Simo-realman/Two-Finger-Gripper/doc/image7.jpg

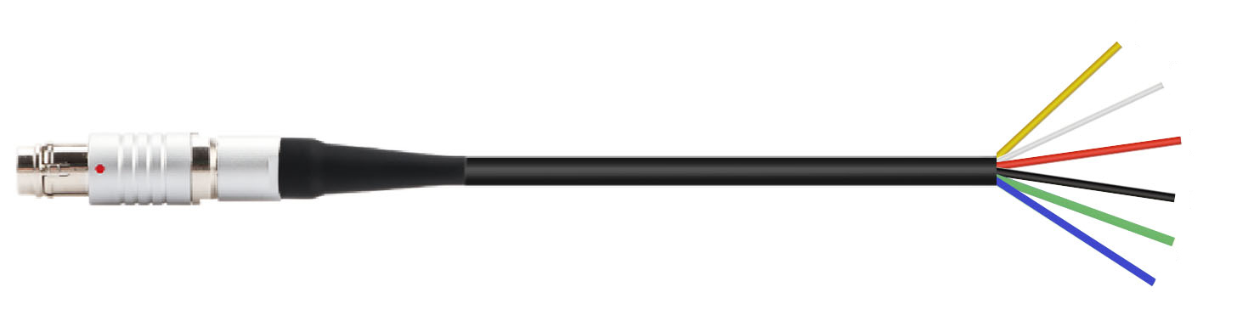
doc/image7.jpg
