Simo-realman/Two-Finger-Gripper/Software/gripper_app/Code/algo/release/structural_sketch.png

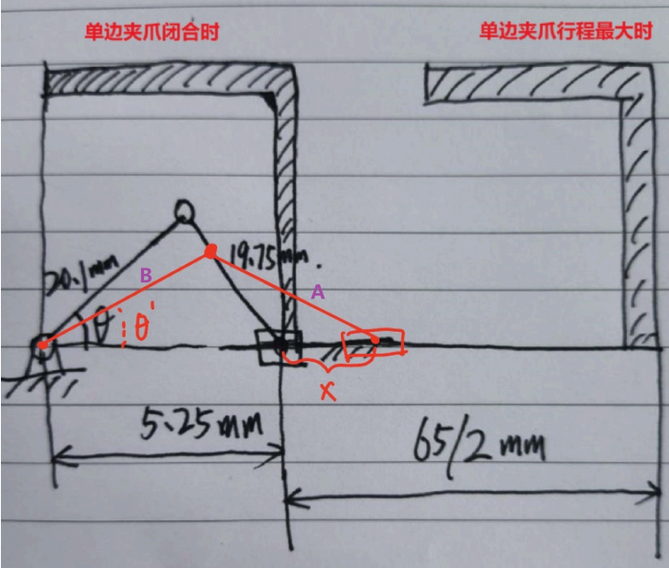
Software/gripper_app/Code/algo/release/structural_sketch.png
