Simo-realman/Two-Finger-Gripper/Software/gripper_tool/image/mainpage.jpg

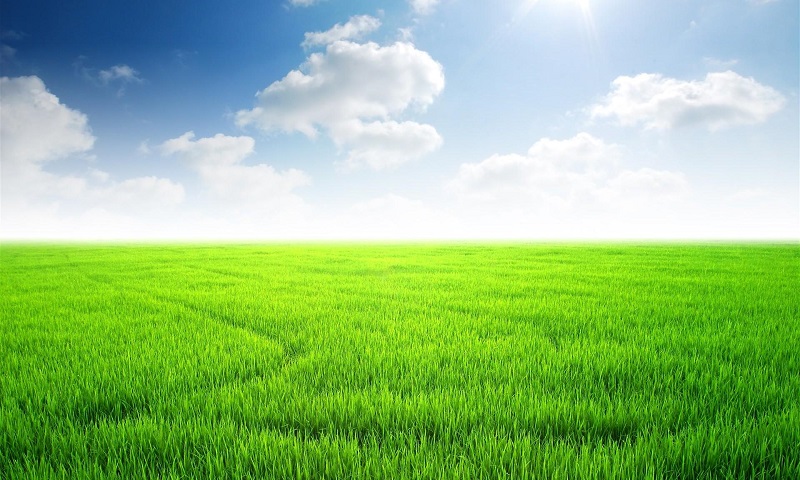
Software/gripper_tool/image/mainpage.jpg
