Simo-realman/Two-Finger-Gripper/Hardware/BOM/Claw Interface Board BOM.xls

夹爪转接板V2.0.0 BOM（20240814）（料号：020201.00**）
序号 | 料号（新） | 料号 | 元件类型 | 品牌 | 推荐型号 | 购买历史/替代型号 | 元件规格 | 封装 | 位置 | 数量
1 | 030103.0001 | RM.311030004 | 贴片电阻 | 国巨 | 0402WGF0000TCE | AC0402FR-070RL | 0R ±1% 0402 | 0402R | R1, R98 | 2
2 | 030103.0073 | RM.311030130 | 贴片电阻 | 厚声 | 0603WAF0000T5E |  | 0R ±1% 0603 | 0603 | F7,R58 | 2
3 | 030103.0042 | RM.311030092 | 贴片电阻 | 国巨 | RC0402FR-07120RL |  | 120Ω ±1% 0402 | 0402R | R29 | 1
4 | 030103.0041 | RM.311030091 | 贴片电阻 | 国巨 | RC0603FR-07120RL | RTT031200FTP | 120R 1% 0603 | 0603R | R27 | 1
5 | 030103.0032 | RM.311030073 | 贴片电阻 | 厚声 | 0402WGF1501TCE | RC0402FR-071K5L | 1.5K 5% 0402 | 0402R | R56, | 1
6 | 030103.0057 | RM.311030113 | 贴片电阻 | 国巨 | 0402WGF4701TCE | RC0402FR-074K7L | 4.7K ±1% 0402 | 0402R | R33,R42 | 2
7 | 030103.0076 | RM.311030133 | 贴片电阻 | 厚声 | 1206W4J0622T5 |  | 6.2k 5% 1206 | R1206 | R32, R41 | 2
8 | 030103.0031 | RM.311030071 | 贴片电阻 | 国巨 | RC0402FR-0710KL | /CR0402F10K0Q10Z/ AC0402FR-0710KL | 10kΩ ±1% 0402 | 0402R | R39, R52, R54,R16,R36,R37,R31, R51, R53 | 9
9 | 030103.0077 | RM.311030134 | 贴片电阻 | 国巨 | RC0402FR-0713K7L |  | 13.7K ±1% 0402 | 0402R | R12 | 1
10 | 030103.0072 | RM.311030100 | 贴片电阻 | 国巨 | RC0402FR-0720KL | AC0402FR-0720KL | 20kΩ ±1% 0402 | 0402R | R7 | 1
11 | 030103.0038 | RM.311030086 | 贴片电阻 | 厚声 | 0402WGF1003TCE | /RTT021003FTH/ RC-02W1003FT | 100kΩ ±1% 0402 | 0402R | R4, R6, R21 | 3
12 | 030103.0045 | RM.311030095 | 贴片电阻 | 厚声 | 0402WGF1503TCE | CRCW0402150KFKED | 150kΩ ±1% 0402 | 0402R | R9 | 1
13 | 030104.0027 | RM.311040054 | 贴片电容 | FH(风华) | 0402CG150F500NT | C0402C0G150G500NTB | 15pF ±1% 50V C0G 0402 | 0402C | C22 | 1
14 | 030104.0049 | RM.311040083 | 贴片电容 | 国巨 | CC0402JRNPO9BN331 | C1005NP0331JGT | 330pF ±5% 50V NPO 0402 | 0402C | C12 | 1
15 | 030104.0052 | RM.311040087 | 贴片电容 | FH(风华) | 0402B822K500CT/ |  | 8.2nF ±10% 50V X7R 0402 | 0402C | C18 | 1
16 | 030104.0008 | RM.311040088 | 贴片电容 | 国巨 | CC0402JRX7R9BB103 |  | 10nF ±5% 50V X7R 0402 | 0402C | C37, C39, C41 | 3
17 | 030104.0023 | RM.311040048 | 贴片电容 | 国巨 | CC0402KRX7R9BB104 |  | 100nF ±10% 50V X7R 0402 | 0402C | C3, C7, C8, C13, C23, C25, C26, C28, C30, C32, C35,C38, C40, C51,C5 | 15
18 | 030104.0026 | RM.311040053 | 贴片电容 | 国巨 | CC0805KKX7R0BB104 | C2012X7R2A104K125AA | 100nF ±10% 100V X7R 0805 | 0805C | C1 | 1
19 | 030104.0028 | RM.311040055 | 贴片电容 | 国巨 | CC0603KRX7R6BB105 |  | 1uF ±10% 10V X7R 0603 | 0603C | C19, C20,C29, | 3
20 | 030104.0036 | RM.311040064 | 贴片电容 | muRata(村田) | GRM21BR61A476ME15L |  | 47uF ±20% 10V X5R 0805 | 0805C | C9, C10 | 2
21 | 030104.0043 | RM.311040072 | 贴片电容 | PSA(信昌电陶) | FS32X106K500EGG | UMK325BJ106KM-P | 10uF(106) ±10% 50V X7R 1210 | C1210 | C11 | 1
22 | 030104.0019 | RM.311040037 | 贴片电容 | 三星 | CL31B106KBHNNNE |  | 10uF ±10% 50V X7R 1206 | 1206C | C2 ,C52, C53, C55, C56 | 5
23 | 030104.0038 | RM.311040066 | 贴片电容 | muRata(村田) | GRM21BR61H106KE43L |  | 10uF ±10% 50V X5R 0805 | 0805C | C14, | 1
24 | 030104.0017 | RM.311040033 | 贴片电容 | muRata(村田) | GRM188Z71A106KA73D |  | 10uF ±10% 10V X7R 0603 | 0603C | C27, C31 | 2
25 | 030104.0037 | RM.311040065 | 贴片电容 | 三星 | CL21A226MAYNNNE |  | 22uF ±20% 25V X5R 0805 | 0805C | C15, C16, C17, C48 | 4
26 | 030109.0002 | RM.311090005 | 磁珠BEAD | Sunlord(顺络) | GZ1005E601CTF |  | 磁珠600 Ohms@100MHz | 0402R | L3 | 1
27 | 030106.0024 | RM.311060043 | 二极管 | MDD | SS54F |  | SS54F 40V 5A 550mV@5A 肖特基二极管 | SMAF | D2 | 1
28 | 030106.0016 | RM.311060027 | 二极管 | 时科 | SS26FL |  | SS26FL SMAF | SS26FL | D6 | 1
29 | 030109.0008 | RM.311090028 | 贴片电感 | BOURNS | SRN8040TA-150M |  | SRN8040TA-150M 15uH 3.6A 50mΩ | VLP8040 | L1 | 1
30 | 030109.0003 | RM.311090018 | 贴片电感 | Sunlord(顺络) | SWPA4030S3R3MT |  | 贴片功率电感3.3uH ±20% 2.4A | L4030 | L2 | 1
31 | 030102.0032 | RM.311020061 | 电源芯片 | TI(德州仪器) | LMR14020SDDAR |  | LMR14020SDDAR DC-DC电源芯片//SO PowerPAD-8 降压型 输入电压：4V~40V 输出电压：800mV~28V 输出电流(最大值)：2A | HSOP-8-EP | U1 | 1
32 | 030102.0047 | RM.311020079 | 电源芯片 | TI(德州仪器) | LMR51420YDDC |  | LMR51420YDDC 降压型 输入4.5V~36V 输出600mV~34.2V 2A | TSOT23-6 | U2 | 1
33 | 030102.0026 | RM.311020050 | 电源芯片 | MICRONE(南京微盟) | ME6215C33M5G |  | ME6215C33M5G SOT23-5 | SOT-23-5 | U3 | 1
34 | 030102.0056 | RM.311020020 | CAN芯片 | 3PEAK | TPT1256L1-DF6R | MCP2544FDT-H/MF | CAN FD transceiver | DFN8 | U5 | 1
35 | 030102.0004 | RM.311020005 | 主芯片 | ST | STM32G431CBU6 库存带Y标志优先用 |  | STM32G431CBU6 | UFQFPN48 | U6 | 1
36 | 030102.0066 | RM.311020021 | RS485芯片 | SIT(芯力特) | SIT3088EEUA（030102.0066） | SIT3485EUA （030102.0012） | 收发器 驱动器/接收器：1/1 数据速率：12Mbps 小外型封装，3.3V供电，256节点，12Mbps，半双工RS485/ | VSSOP8/ MSOP-8 | U7 | 1
37 | 030102.0014 | RM.311020024 | 光耦 | RENESAS(瑞萨) | PS2801-1-F3 | IS2801 | 光耦 PS2801-1 SOP-4 | SSOP4 | U9, U12 | 2
38 | 030102.0037 | RM.311020069 | 达林顿管 | Mixic(中科芯亿达) | ULN2001D |  | ULN2001D SOP-8 | SOP-8 | U10 | 1
39 | 030108.0004 | RM.311080007 | 有源晶振 | SCTF(星通时频) | SX3M8.000M20F30TNN |  | 8M 3.3V SMD3225-4P | XTAL_3225 | Y1 | 1
40 | 030106.0017 | RM.311060032 | LED RGB | TUOZHAN(拓展光电) | S4-3528RGBTA-A |  | RGB3528共阳极 | LED_3528 | RGB1 | 1
41 |  | RM.311060022 | 二极管 | MDD/晶导微 | SMAJ40CA |  | SMAJ40CA | SMA_L4.4-W2.8-LS5.1-BI | D5 | 1
42 |  |  | 二极管 | CJ(江苏长电 /长晶) | ESDBW18VD3 |  | 静电和浪涌保护 | SOD-323A | D7 | 1
43 |  | RM.311060056 | 稳压管 | LRC(乐山无线电） | LBZT52C5V6T1G |  | 稳压值(标称值)：5.6V 稳压值(范围)：5.2V~6V 功率：500mW | SOD-123 | D9 | 1
44 |  |  | ESD保护器件 | Brightking (君耀电子) | LBT23C24L02 |  | LBT23C24L02 | SOT-23-3 | ESD1 | 1
5 | 030103.0032 | RM.311030073 | 贴片电阻 | 厚声 | 0402WGJ0680TCE |  | 68Ω 5% 0402 | 0402R | R55, R57 | 2
 |  |  | ESD保护器件 | TECH PUBLIC (台舟) | ESD5302F |  | ESD5302F | SOT-23-3 | ESD1 | 1
 |  |  | 更新事项：
 |  |  | 1>.将ESDLBT23C24L02替换为ESD5302F
 |  |  | 2>.
 |  |  | 3>.
 |  |  | 4>,
 |  |  | 5>,
