Simo-realman/Two-Finger-Gripper/Related Files/Two-Finger Parallel Gripper Test Cases.xlsx

Sheet: 整机结构测试
序号 | 模块 | 优先级 | 概要 | 描述 | 前提条件 | 步骤 | 预期结果 | 执行结果
NO.1 | 两指平行夹爪 | Medium | 整机尺寸 |  | 1、待测试夹爪 2、长度测量工具 | 1、使用量具对产品的长、宽、高进行测量 | 使用卡尺测量夹爪的三维尺寸（长、宽、高），确认是否在110x60x120mm的公差范围内
NO.2 | 两指平行夹爪 | Medium | 外观 |  | 1、待测试夹爪 | 1、观察夹爪外观 | 夹爪的外观简约、流畅、圆润，颜色为黑白相间，并喷漆质量均匀无瑕疵。
NO.3 | 两指平行夹爪 | Medium | 行程 |  | 1、待测试夹爪 2、长度测量工具 | 1、将夹爪打开至最大开口度 2、使用量具对产品的行程进行测量 | 夹爪行程：65mm±0.5mm
NO.4 | 两指平行夹爪 | Medium | 指高 |  | 1、待测试夹爪 2、长度测量工具 | 1、使用量具对产品的指高进行测量 | 夹爪指高：40mm±0.5mm
NO.5 | 两指平行夹爪 | Medium | 本体重量 |  | 1、待测试夹爪 2、质量测量工具 | 1、使用量具对产品的质量进行测量 | 夹爪质量：≤500g±10g
NO.6 | 两指平行夹爪 | Medium | 额定负载3.5kg（静态夹爪垂直向下夹取） |  | 1、待测试夹爪 2、连接到机械臂末端 3、机械臂上电初始化完成 | 1、进入web示教器：192.168.1.18 2、进入拓展-末端控制 3、点击工具端电源输出，选中24V 4、勾选夹爪进行夹爪使能 5、使用夹爪夹取3.5kg重物 6、观察夹爪夹取情况 | 夹爪能够静态夹取3.5kg重物不掉落
NO.7 | 两指平行夹爪 | Medium | 额定负载3.5kg（静态夹爪水平方向夹取） |  | 1、待测试夹爪 2、连接到机械臂末端 3、机械臂上电初始化完成 | 1、进入web示教器：192.168.1.18 2、进入拓展-末端控制 3、点击工具端电源输出，选中24V 4、勾选夹爪进行夹爪使能 5、使用夹爪夹取3.5kg重物 6、观察夹爪夹取情况 | 夹爪能够静态夹取3.5kg重物不掉落
NO.8 | 两指平行夹爪 | Medium | 额定负载3.5kg（静态夹爪垂直向上夹取） |  | 1、待测试夹爪 2、连接到机械臂末端 3、机械臂上电初始化完成 | 1、进入web示教器：192.168.1.18 2、进入拓展-末端控制 3、点击工具端电源输出，选中24V 4、勾选夹爪进行夹爪使能 5、使用夹爪夹取3.5kg重物 6、观察夹爪夹取情况 | 夹爪能够静态夹取3.5kg重物不掉落
NO.9 | 两指平行夹爪 | Medium | 额定负载3.5kg（静态夹爪夹取方向与地面形成45°夹角夹取） |  | 1、待测试夹爪 2、连接到机械臂末端 3、机械臂上电初始化完成 | 1、进入web示教器：192.168.1.18 2、进入拓展-末端控制 3、点击工具端电源输出，选中24V 4、勾选夹爪进行夹爪使能 5、使用夹爪夹取3.5kg重物 6、观察夹爪夹取情况 | 夹爪能够静态夹取3.5kg重物不掉落
NO.10 | 两指平行夹爪 | Medium | 额定负载3.5kg（静态夹爪夹取方向与地面形成135°夹角夹取） |  | 1、待测试夹爪 2、连接到机械臂末端 3、机械臂上电初始化完成 | 1、进入web示教器：192.168.1.18 2、进入拓展-末端控制 3、点击工具端电源输出，选中24V 4、勾选夹爪进行夹爪使能 5、使用夹爪夹取3.5kg重物 6、观察夹爪夹取情况 | 夹爪能够静态夹取3.5kg重物不掉落
NO.11 | 两指平行夹爪 | Medium | 额定负载3.5kg动态夹取 |  | 1、待测试夹爪 2、连接到机械臂末端 3、机械臂上电初始化完成 | 1、进入web示教器：192.168.1.18 2、进入拓展-末端控制 3、点击工具端电源输出，选中24V 4、勾选夹爪进行夹爪使能 5、使用夹爪夹取3.5kg重物 6、进入在线编程，编写使机械臂在各种姿态运行程序任务循环 7、观察机械臂运行时夹爪夹取情况 | 夹爪能够动态夹取3.5kg重物不掉落
NO.12 | 两指平行夹爪 | Medium | 最大负载5kg（静态夹爪垂直向下夹取） |  | 1、待测试夹爪 2、连接到机械臂末端 3、机械臂上电初始化完成 | 1、进入web示教器：192.168.1.18 2、进入拓展-末端控制 3、点击工具端电源输出，选中24V 4、勾选夹爪进行夹爪使能 5、使用夹爪夹取5kg重物 6、观察夹爪夹取情况 | 夹爪能够静态夹取5kg重物不掉落
NO.13 | 两指平行夹爪 | Medium | 最大负载5kg（静态夹爪水平方向夹取） |  | 1、待测试夹爪 2、连接到机械臂末端 3、机械臂上电初始化完成 | 1、进入web示教器：192.168.1.18 2、进入拓展-末端控制 3、点击工具端电源输出，选中24V 4、勾选夹爪进行夹爪使能 5、使用夹爪夹取5kg重物 6、观察夹爪夹取情况 | 夹爪能够静态夹取5kg重物不掉落
NO.14 | 两指平行夹爪 | Medium | 最大负载5kg（静态夹爪垂直向上夹取） |  | 1、待测试夹爪 2、连接到机械臂末端 3、机械臂上电初始化完成 | 1、进入web示教器：192.168.1.18 2、进入拓展-末端控制 3、点击工具端电源输出，选中24V 4、勾选夹爪进行夹爪使能 5、使用夹爪夹取5kg重物 6、观察夹爪夹取情况 | 夹爪能够静态夹取5kg重物不掉落
NO.15 | 两指平行夹爪 | Medium | 最大负载5kg（静态夹爪夹取方向与地面形成45°夹角夹取） |  | 1、待测试夹爪 2、连接到机械臂末端 3、机械臂上电初始化完成 | 1、进入web示教器：192.168.1.18 2、进入拓展-末端控制 3、点击工具端电源输出，选中24V 4、勾选夹爪进行夹爪使能 5、使用夹爪夹取5kg重物 6、观察夹爪夹取情况 | 夹爪能够静态夹取5kg重物不掉落
NO.16 | 两指平行夹爪 | Medium | 最大负载5kg（静态夹爪夹取方向与地面形成135°夹角夹取） |  | 1、待测试夹爪 2、连接到机械臂末端 3、机械臂上电初始化完成 | 1、进入web示教器：192.168.1.18 2、进入拓展-末端控制 3、点击工具端电源输出，选中24V 4、勾选夹爪进行夹爪使能 5、使用夹爪夹取5kg重物 6、观察夹爪夹取情况 | 夹爪能够静态夹取5kg重物不掉落
NO.17 | 两指平行夹爪 | Medium | 夹持力测试 |  | 1、待测试夹爪 2、上位机软件 3、测力计 4、夹爪和测力计上电处于工作状态 | 1、上位机设置夹爪的夹取速度为1000，夹取力为1000 2、将测力计放置在夹爪的夹指之间 3、点击持续夹取按钮 4、使用量具对产品的夹持力进行测量 | 夹持力最大可达60N
NO.18 | 两指平行夹爪 | Medium | 打开/闭合时间 |  | 1、待测试夹爪 2、串口测试工具 3、夹爪上电后处于工作状态 | 1、串口工具和夹爪通讯完成 2、在串口工具上设置夹爪开合循环、命令下发时间：300ms 3、开始循环，并观察夹爪开合状态 | 单行程开/合时间为0.3s
NO.19 | 两指平行夹爪 | Medium | 位置重复精度 |  | 1、待测试夹爪 2、上位机软件 3、千分表 4、测试工装 5、完成夹爪，千分表和测试工装的组装（参考图5） | 1、控制夹爪打开/闭合 2、计算夹爪的位置重复精度 | 夹爪位置重复精度为±0.1mm
NO.20 | 两指平行夹爪 | Medium | 夹爪指尖更换 |  | 1、带测试夹爪 2、匹配的螺丝 3、原装夹指和外夹指 | 1、将原配指尖拆卸，替换为外夹指 | 产品可通过替换夹指，满足更多的目标抓取的需要
NO.21 | 两指平行夹爪 | Medium | 外夹指行程 |  | 1、待测试外夹指 2、长度测量工具 | 1、使用量具对产品的外夹指行程进行测量 | 100mm
NO.22 | 两指平行夹爪 | Medium | 安装角度 |  | 1、待测试夹爪、末端法兰转接件件、视觉相机、适配固定螺、RM65b机械臂 | 1、按先后顺序将视觉相机，夹爪安装至RM65b机械臂末端 2、观察安装后夹爪角度是否与相机平行 3、通过web示教器开合夹爪，观察夹爪开合是否影响相机拍摄 | 夹爪的安装角度与相机平行
NO.23 | 两指平行夹爪 | Medium | 末端法兰，快插接口安装 |  | 1、待测试夹爪，末端法兰转接件，RM65B机械臂，适配螺丝及工具 2、双头航插线 | 1、将夹爪通过末端法兰安装至RM65B机械臂末端 2、使用双头航插线连接机械臂末端和夹爪 | 可通过末端法兰和快插接口快速安装夹爪满足工作环境需要
NO.24 | 两指平行夹爪 | Medium | 航插位置 |  | 1、待测试夹爪 | 1、观测航插接口位置 | 航插接口位于夹爪台阶下面
NO.25 | 两指平行夹爪 | Medium | 掉电缓冲（正在打开） |  | 1、待测试夹爪 2、移动电源 3、夹爪上位机供电 4、使夹爪处于工作状态 | 1、上位机下发打开指令 2、夹爪打开到开口度500时，断电 3、观测夹爪掉电后状态 | 掉电后手爪受载荷重力影响，缓慢张开
NO.26 | 两指平行夹爪 | Medium | 掉电缓冲（正在闭合 |  | 1、待测试夹爪 2、移动电源 3、夹爪上位机供电 4、使夹爪处于工作状态 | 1、上位机下发闭合指令 2、夹爪闭合到开口度500时，断电 3、观测夹爪掉电后状态 | 掉电后手爪受载荷重力影响，缓慢张开
NO.27 | 两指平行夹爪 | Medium | 材料 |  | 1、待测试夹爪 | 1、检测夹爪材质 | 铝合金外壳为主、ABS为辅
NO.28 | 两指平行夹爪 | Medium | 外观 |  | 1、待测试夹爪 | 1、观察夹爪外观 | 外观简约、流畅、圆润，与RM机械臂风格相近，颜色为黑白相间
NO.29 | 两指平行夹爪 | Medium | 表面工艺 |  | 1、待测试夹爪 | 1、观察夹爪表面工艺 | 喷漆：喷砂氧化
NO.30 | 两指平行夹爪 | Medium | 额定电压 |  | 1、待测试夹爪 2、移动电源 3、夹爪上位机 | 1、将移动电源调整至24V电压，2A电流对夹爪进行供电 2、上位机下发打开闭合指令 3、观察夹爪工作状态 | 夹爪可在24V供电下使用
NO.31 | 两指平行夹爪 | Medium | 额定电流 |  | 1、待测试夹爪 2、移动电源 3、夹爪上位机 | 1、将移动电源调整至24V电压，0.8A电流对夹爪进行长时间供电 2、上位机下发打开闭合指令 3、观察夹爪工作状态 | 可用24V电压，0.8A电流对夹爪进行供电
NO.32 | 两指平行夹爪 | Medium | 最大电流 |  | 1、待测试夹爪 2、移动电源 3、夹爪上位机 | 1、将移动电源调整至24V电压，2.4A电流对夹爪进行长时间供电 2、上位机下发打开闭合指令 3、观察夹爪工作状态 | 可用24V电压，2.4A电流对夹爪进行供电
NO.33 | 两指平行夹爪 | Medium | 供电 |  | 1、待测试03关节 2、移动电源 | 1、使用20V电压，0.8A电流对03关节进行供电 | 03关节可正常运转
NO.34 | 两指平行夹爪 | Medium | 供电 |  | 1、待测试03关节 2、移动电源 | 1、使用30V电压，2.4A电流对03关节进行供电 | 03关节可正常运转
NO.35 | 两指平行夹爪 | Medium | 供电 |  | 1、待测试03关节 2、移动电源 | 1、使用10V电压，0.5A电流对03关节进行供电 | 供电功率无法支持03关节正常运转
NO.36 | 两指平行夹爪 | Medium | 供电 |  | 1、待测试03关节 2、移动电源 | 1、使用40V电压，4A电流对03关节进行供电 | 供电功率超出03关节运转负荷
NO.37 | 两指平行夹爪 | Medium | 最小夹持力 |  | 1、待测试03关节 3、移动电源 | 1、上位机设置夹爪的夹取速度为1，夹取力为50 2、将测力计放置在夹爪的夹指之间 3、点击持续夹取按钮 4、使用量具对产品的夹持力进行测量 | 不锈钢材质 单次夹取：5.8kg 持续夹取：6.4kg

Sheet: 重复定位精度测试1st
 | 航插接口左侧夹指 |  |  |  |  |  | 航插接口侧夹指
重复定位精度测试数据 | 开口度 | 实际距离（mm） | 开口度 | 实际距离（mm） | 开口度 | 实际距离（mm） | 开口度 | 实际距离（mm） | 开口度 | 实际距离（mm） | 开口度 | 实际距离（mm）
 | 50 |  | 70 |  | 100 |  | 50 |  | 70 |  | 100
 | 最大偏值 |  |  |  |  |  | 最大偏值
 | 基准值 |  |  |  |  |  | 基准值
 | 次数 |  |  |  |  |  | 次数
 | 左指 |  |  |  |  |  | 右指

Sheet: 嵌入式软件功能测试
序号 | 模块 | 优先级 | 概要 | 前提条件 | 步骤 | 预期结果 | 执行结果
NO.1 | 数据传输、采集和运动控制 | Medium | 保存参数 | 1、待测试夹爪 2、移动电源（24V供电） 3、485转usb通讯线 4、夹爪航插通讯线 5、完成1-4接线工作（参考图1） 6、设备上电 7、连接串口工具 | 1、通过串口工具下发保存参数指令：EB 90 01 01 01 03 | 1、接受应答帧：EE 16 01 02 01 01 05
NO.2 |  | Medium | 系统恢复默认参数 | 1、待测试夹爪 2、移动电源（24V供电） 3、485转usb通讯线 4、夹爪航插通讯线 5、完成1-4接线工作（参考图1） 6、设备上电 7、连接串口工具 | 1、随机修改系统参数（参考下方用例） 2、通过串口工具下发恢复默认参数指令：EB 90 01 01 02 04 3、断电重启设备 4、设备上电后，上位机查询系统参数 | 2、接受应答帧：EE 16 01 02 02 01 06 4、系统参数恢复默认
NO.3 |  | Medium | 设置波特率为9600 | 1、待测试夹爪 2、移动电源（24V供电） 3、485转usb通讯线 4、夹爪航插通讯线 5、完成1-4接线工作（参考图1） 6、设备上电 7、连接串口工具 | 1、通过串口工具下发设置波特率为9600指令：EB 90 01 02 03 00 06 2、通过串口工具下发保存参数指令：EB 90 01 01 01 03 3、断电重启设备 4、设备上电后，上位机查询波特率 | 1、接受应答帧：EE 16 01 02 03 01 07 2、接受应答帧：EE 16 01 02 01 01 05 3、波特率已修改为9600
NO.4 |  | Medium | 设置波特率为19200 | 1、待测试夹爪 2、移动电源（24V供电） 3、485转usb通讯线 4、夹爪航插通讯线 5、完成1-4接线工作（参考图1） 6、设备上电 7、连接串口工具 | 1、通过串口工具下发设置波特率为19200指令：EB 90 01 02 03 01 07 2、通过串口工具下发保存参数指令：EB 90 01 01 01 03 3、断电重启设备 4、设备上电后，上位机查询波特率 | 1、接受应答帧：EE 16 01 02 03 01 07 2、接受应答帧：EE 16 01 02 01 01 05 3、波特率已修改为19200
NO.5 |  | Medium | 设置波特率为38400 | 1、待测试夹爪 2、移动电源（24V供电） 3、485转usb通讯线 4、夹爪航插通讯线 5、完成1-4接线工作（参考图1） 6、设备上电 7、连接串口工具 | 1、通过串口工具下发设置波特率为38400指令：EB 90 01 02 03 02 08 2、通过串口工具下发保存参数指令：EB 90 01 01 01 03 3、断电重启设备 4、设备上电后，上位机查询波特率 | 1、接受应答帧：EE 16 01 02 03 01 07 2、接受应答帧：EE 16 01 02 01 01 05 3、波特率已修改为38400
NO.6 |  | Medium | 设置波特率为57600 | 1、待测试夹爪 2、移动电源（24V供电） 3、485转usb通讯线 4、夹爪航插通讯线 5、完成1-4接线工作（参考图1） 6、设备上电 7、连接串口工具 | 1、通过串口工具下发设置波特率为57600指令：EB 90 01 02 03 03 09 2、通过串口工具下发保存参数指令：EB 90 01 01 01 03 3、断电重启设备 4、设备上电后，上位机查询波特率 | 1、接受应答帧：EE 16 01 02 03 01 07 2、接受应答帧：EE 16 01 02 01 01 05 3、波特率已修改为57600
NO.7 |  | Medium | 设置波特率为115200 | 1、待测试夹爪 2、移动电源（24V供电） 3、485转usb通讯线 4、夹爪航插通讯线 5、完成1-4接线工作（参考图1） 6、设备上电 7、连接串口工具 | 1、通过串口工具下发设置波特率为57600指令：EB 90 01 02 03 04 0A 2、通过串口工具下发保存参数指令：EB 90 01 01 01 03 3、断电重启设备 4、设备上电后，上位机查询波特率 | 1、接受应答帧：EE 16 01 02 03 01 07 2、接受应答帧：EE 16 01 02 01 01 05 3、波特率已修改为115200
NO.8 |  | Medium | 设置波特率为460800 | 1、待测试夹爪 2、移动电源（24V供电） 3、485转usb通讯线 4、夹爪航插通讯线 5、完成1-4接线工作（参考图1） 6、设备上电 7、连接串口工具 | 1、通过串口工具下发设置波特率为57600指令：EB 90 01 02 03 05 0B 2、通过串口工具下发保存参数指令：EB 90 01 01 01 03 3、断电重启设备 4、设备上电后，上位机查询波特率 | 1、接受应答帧：EE 16 01 02 03 01 07 2、接受应答帧：EE 16 01 02 01 01 05 3、波特率已修改为460800
NO.9 |  | Medium | 设置夹爪id为1 | 1、待测试夹爪 2、移动电源（24V供电） 3、485转usb通讯线 4、夹爪航插通讯线 5、完成1-4接线工作（参考图1） 6、设备上电 7、连接串口工具 | 1、通过串口工具下发设置夹爪ID为1指令：EB 90 01 02 04 01 08 2、通过串口工具下发保存参数指令：EB 90 01 01 01 03 3、断电重启设备 4、设备上电后，上位机查询夹爪ID | 1、接受应答帧：EE 16 01 02 04 01 08 2、接受应答帧：EE 16 01 02 01 01 05 3、夹爪ID已设置为1
NO.10 |  | Medium | 设置夹爪id为7 | 1、待测试夹爪 2、移动电源（24V供电） 3、485转usb通讯线 4、夹爪航插通讯线 5、完成1-4接线工作（参考图1） 6、设备上电 7、连接串口工具 | 1、通过串口工具下发设置夹爪ID为1指令：EB 90 01 02 04 07 0E 2、通过串口工具下发保存参数指令：EB 90 01 01 01 03 3、断电重启设备 4、设备上电后，上位机查询夹爪ID | 1、接受应答帧：EE 16 01 02 04 01 08 2、接受应答帧：EE 16 01 02 01 01 05 3、夹爪ID已设置为7
NO.11 |  | Medium | 设置夹爪id为21 | 1、待测试夹爪 2、移动电源（24V供电） 3、485转usb通讯线 4、夹爪航插通讯线 5、完成1-4接线工作（参考图1） 6、设备上电 7、连接串口工具 | 1、通过串口工具下发设置夹爪ID为1指令：EB 90 01 02 04 15 1C 2、通过串口工具下发保存参数指令：EB 90 01 01 01 03 3、断电重启设备 4、设备上电后，上位机查询夹爪ID | 1、接受应答帧：EE 16 01 02 04 01 08 2、接受应答帧：EE 16 01 02 01 01 05 3、夹爪ID已设置为21
NO.12 |  | Medium | 设置夹爪id为35 | 1、待测试夹爪 2、移动电源（24V供电） 3、485转usb通讯线 4、夹爪航插通讯线 5、完成1-4接线工作（参考图1） 6、设备上电 7、连接串口工具 | 1、通过串口工具下发设置夹爪ID为1指令：EB 90 01 02 04 23 2A 2、通过串口工具下发保存参数指令：EB 90 01 01 01 03 3、断电重启设备 4、设备上电后，上位机查询夹爪ID | 1、接受应答帧：EE 16 01 02 04 01 08 2、接受应答帧：EE 16 01 02 01 01 05 3、夹爪ID已设置为35
NO.13 |  | Medium | 查询夹爪ID | 1、待测试夹爪 2、移动电源（24V供电） 3、485转usb通讯线 4、夹爪航插通讯线 5、完成1-4接线工作（参考图1） 6、设备上电 7、连接串口工具 | 1、通过串口工具下发查询夹爪ID指令：EB 90 FF 01 05 05 | 1、设备ID为1时应答帧：EE 16 01 02 05 01 09
NO.14 |  | Medium | 以设置的速度300和力控200夹取 | 1、待测试夹爪 2、移动电源（24V供电） 3、485转usb通讯线 4、夹爪航插通讯线 5、完成1-4接线工作（参考图1） 6、设备上电 7、连接串口工具 | 1、通过串口工具下发以力矩为200，速度为300单次夹取指令：EB 90 01 05 18 2C 01 C8 00 13 | 1、接受应答帧：EE 16 01 02 18 01 1C
NO.15 |  | Medium | 以设置的速度1和力控50夹取 | 1、待测试夹爪 2、移动电源（24V供电） 3、485转usb通讯线 4、夹爪航插通讯线 5、完成1-4接线工作（参考图1） 6、设备上电 7、连接串口工具 | 1、通过串口工具下发以力矩为50，速度为1单次夹取指令：EB 90 01 05 18 01 00 32 00 51 | 1、接受应答帧：EE 16 01 02 18 01 1C
NO.16 |  | Medium | 以设置的速度500和力控500夹取 | 1、待测试夹爪 2、移动电源（24V供电） 3、485转usb通讯线 4、夹爪航插通讯线 5、完成1-4接线工作（参考图1） 6、设备上电 7、连接串口工具 | 1、通过串口工具下发以力矩为500，速度为500单次夹取指令：EB 90 01 05 18 F4 01 F4 01 08 | 1、接受应答帧：EE 16 01 02 18 01 1C
NO.17 |  | Medium | 以设置的速度1000和力控1000夹取 | 1、待测试夹爪 2、移动电源（24V供电） 3、485转usb通讯线 4、夹爪航插通讯线 5、完成1-4接线工作（参考图1） 6、设备上电 7、连接串口工具 | 1、通过串口工具下发以力矩为1000，速度为1000单次夹取指令：EB 90 01 05 18 E8 03 E8 03 F4 | 1、接受应答帧：EE 16 01 02 18 01 1C
NO.18 |  | Medium | 以设置的速度1松开 | 1、待测试夹爪 2、移动电源（24V供电） 3、485转usb通讯线 4、夹爪航插通讯线 5、完成1-4接线工作（参考图1） 6、设备上电 7、连接串口工具 | 1、通过串口工具下发以速度为1松开夹取指令：EB 90 01 03 11 01 00 16 2、观察夹爪松开速度 | 1、接受应答帧：EE 16 01 02 11 01 15 2、夹爪按照1速度松开夹爪
NO.19 |  | Medium | 以设置的速度500松开 | 1、待测试夹爪 2、移动电源（24V供电） 3、485转usb通讯线 4、夹爪航插通讯线 5、完成1-4接线工作（参考图1） 6、设备上电 7、连接串口工具 | 1、通过串口工具下发以速度为500松开夹取指令：EB 90 01 03 11 F4 01 0A 2、观察夹爪松开速度 | 1、接受应答帧：EE 16 01 02 11 01 15 2、夹爪按照500速度松开夹爪
NO.20 |  | Medium | 以设置的速度1000松开 | 1、待测试夹爪 2、移动电源（24V供电） 3、485转usb通讯线 4、夹爪航插通讯线 5、完成1-4接线工作（参考图1） 6、设备上电 7、连接串口工具 | 1、通过串口工具下发以速度为1松开夹取指令：EB 90 01 03 11 E8 03 00 2、观察夹爪松开速度 | 1、接受应答帧：EE 16 01 02 11 01 15 2、夹爪按照1000速度松开夹爪
NO.21 |  | Medium | 设置夹爪开口度限位为0-1000 | 1、待测试夹爪 2、移动电源（24V供电） 3、485转usb通讯线 4、夹爪航插通讯线 5、完成1-4接线工作（参考图1） 6、设备上电 7、连接串口工具 | 1、通过串口工具下发设置夹爪开口度为0-1000指令：EB 90 01 05 12 E8 03 00 00 03 2、下发开合夹爪指令查看夹爪开口度（指令参考上方用例） 3、下发保存指令（参考上方用例） 4、断电重启生效 5、检查是否设置成功 | 1、接受应答帧：EE 16 01 02 12 01 16 2、开口限位0-1000 5、设置成功
NO.22 |  | Medium | 设置夹爪开口度限位200-800 | 1、待测试夹爪 2、移动电源（24V供电） 3、485转usb通讯线 4、夹爪航插通讯线 5、完成1-4接线工作（参考图1） 6、设备上电 7、连接串口工具 | 1、通过串口工具下发设置夹爪开口度为200-800指令：EB 90 01 05 12 20 03 C8 00 03 2、下发开合夹爪指令查看夹爪开口度（指令参考上方用例） 3、下发保存指令（参考上方用例） 4、断电重启生效 5、检查是否设置成功 | 1、接受应答帧：EE 16 01 02 12 01 16 2、开口限位200-800 5、设置成功
NO.23 |  | Medium | 设置夹爪开口度限位400-600 | 1、待测试夹爪 2、移动电源（24V供电） 3、485转usb通讯线 4、夹爪航插通讯线 5、完成1-4接线工作（参考图1） 6、设备上电 7、连接串口工具 | 1、通过串口工具下发设置夹爪开口度为400-600指令：EB 90 01 05 12 58 02 90 01 03 2、下发开合夹爪指令查看夹爪开口度（指令参考上方用例） 3、下发保存指令（参考上方用例） 4、断电重启生效 5、检查是否设置成功 | 1、接受应答帧：EE 16 01 02 12 01 16 2、开口限位400-600 5、设置成功
NO.24 |  | Medium | 查询夹爪开口度限位（400-600） | 1、待测试夹爪 2、移动电源（24V供电） 3、485转usb通讯线 4、夹爪航插通讯线 5、完成1-4接线工作（参考图1） 6、设备上电 7、连接串口工具 | 1、通过串口工具下发查询夹爪开口度指令：EB 90 01 01 13 15 2、检查开口度是否正确 | 1、接受应答帧：EE 16 01 05 13 58 02 90 01 04 2、查询的值对应夹爪实际开口度
NO.25 |  | Medium | 急停 | 1、待测试夹爪 2、移动电源（24V供电） 3、485转usb通讯线 4、夹爪航插通讯线 5、完成1-4接线工作（参考图1） 6、设备上电 7、连接串口工具 | 1、下发夹爪开合指令（参考上方用例） 2、通过串口工具下发查询夹爪开口度指令：EB 90 01 01 16 18 3、观察夹爪运动状态 | 2、接受应答帧：EE 16 01 02 16 01 1A 3、夹爪停止开合
NO.26 |  | Medium | 清楚错误 | 1、待测试夹爪 2、移动电源（24V供电） 3、485转usb通讯线 4、夹爪航插通讯线 5、完成1-4接线工作（参考图1） 6、设备上电 7、连接串口工具 | 1、通过串口工具下发清除错误指令：EB 90 01 01 17 19 | 1、接受应答帧：EE 16 01 02 17 01 1B
NO.27 |  | Medium | 以设置的速度300和力控200持续夹取 | 1、待测试夹爪 2、移动电源（24V供电） 3、485转usb通讯线 4、夹爪航插通讯线 5、完成1-4接线工作（参考图1） 6、设备上电 7、连接串口工具 | 1、通过串口工具下发以力矩为200，速度为300持续夹取指令：EB 90 01 05 18 2C 01 C8 00 13 | 1、接受应答帧：EE 16 01 02 18 01 1C
NO.28 |  | Medium | 以设置的速度1和力控50持续夹取 | 1、待测试夹爪 2、移动电源（24V供电） 3、485转usb通讯线 4、夹爪航插通讯线 5、完成1-4接线工作（参考图1） 6、设备上电 7、连接串口工具 | 1、通过串口工具下发以力矩为50，速度为1持续夹取指令：EB 90 01 05 18 01 00 32 00 51 | 1、接受应答帧：EE 16 01 02 18 01 1C
NO.29 |  | Medium | 以设置的速度500和力控500持续夹取 | 1、待测试夹爪 2、移动电源（24V供电） 3、485转usb通讯线 4、夹爪航插通讯线 5、完成1-4接线工作（参考图1） 6、设备上电 7、连接串口工具 | 1、通过串口工具下发以力矩为500，速度为500持续夹取指令：EB 90 01 05 18 F4 01 F4 01 08 | 1、接受应答帧：EE 16 01 02 18 01 1C
NO.30 |  | Medium | 以设置的速度1000和力控1000持续夹取 | 1、待测试夹爪 2、移动电源（24V供电） 3、485转usb通讯线 4、夹爪航插通讯线 5、完成1-4接线工作（参考图1） 6、设备上电 7、连接串口工具 | 1、通过串口工具下发以力矩为1000，速度为1000持续夹取指令：EB 90 01 05 18 E8 03 E8 03 F4 | 1、接受应答帧：EE 16 01 02 18 01 1C
NO.31 |  | Medium | 设置控制力为50 | 1、待测试夹爪 2、移动电源（24V供电） 3、485转usb通讯线 4、夹爪航插通讯线 5、完成1-4接线工作（参考图1） 6、设备上电 7、连接串口工具 | 1、通过串口工具下发设置控制力为50指令：EB 90 01 03 19 32 00 4F 2、下发保存指令（参考上方用例） 3、断电重启生效 4、检查控制力是否设置成功 | 1、接受应答帧：EE 16 01 02 19 01 1D 4、设置成功
NO.32 |  | Medium | 设置控制力为500 | 1、待测试夹爪 2、移动电源（24V供电） 3、485转usb通讯线 4、夹爪航插通讯线 5、完成1-4接线工作（参考图1） 6、设备上电 7、连接串口工具 | 1、通过串口工具下发设置控制力为50指令：EB 90 01 03 19 F4 01 12 2、下发保存指令（参考上方用例） 3、断电重启生效 4、检查控制力是否设置成功 | 1、接受应答帧：EE 16 01 02 19 01 1D 4、设置成功
NO.33 |  | Medium | 设置控制力为1000 | 1、待测试夹爪 2、移动电源（24V供电） 3、485转usb通讯线 4、夹爪航插通讯线 5、完成1-4接线工作（参考图1） 6、设备上电 7、连接串口工具 | 1、通过串口工具下发设置控制力为50指令：EB 90 01 03 19 E8 03 08 2、下发保存指令（参考上方用例） 3、断电重启生效 4、检查控制力是否设置成功 | 1、接受应答帧：EE 16 01 02 19 01 1D 4、设置成功
NO.34 |  | Medium | 设置IO1模式（输入） | 1、待测试夹爪 2、移动电源（24V供电） 3、485转usb通讯线 4、夹爪航插通讯线 5、完成1-4接线工作（参考图1） 6、设备上电 7、连接串口工具 | 1、通过串口工具下发设置IO1输入模式指令：EB 90 01 03 1B 00 00 1F 2、下发查询指令验证是否设置成功（指令参考读取IO输出电平用例） | 1、接受应答帧：EE 16 01 02 1B 01 1F 2、设置成功
NO.35 |  | Medium | 设置IO1模式（输出） | 1、待测试夹爪 2、移动电源（24V供电） 3、485转usb通讯线 4、夹爪航插通讯线 5、完成1-4接线工作（参考图1） 6、设备上电 7、连接串口工具 | 1、通过串口工具下发设置IO1输出模式指令：EB 90 01 03 1B 00 01 20 2、下发查询指令验证是否设置成功（指令参考读取IO输出电平用例） | 1、接受应答帧：EE 16 01 02 1B 01 1F 2、设置成功
NO.36 |  | Medium | 设置IO2模式（输入） | 1、待测试夹爪 2、移动电源（24V供电） 3、485转usb通讯线 4、夹爪航插通讯线 5、完成1-4接线工作（参考图1） 6、设备上电 7、连接串口工具 | 1、通过串口工具下发设置IO2输入模式指令：EB 90 01 03 1B 01 00 20 2、下发查询指令验证是否设置成功（指令参考读取IO输出电平用例） | 1、接受应答帧：EE 16 01 02 1B 01 1F 2、设置成功
NO.37 |  | Medium | 设置IO2模式（输出） | 1、待测试夹爪 2、移动电源（24V供电） 3、485转usb通讯线 4、夹爪航插通讯线 5、完成1-4接线工作（参考图1） 6、设备上电 7、连接串口工具 | 1、通过串口工具下发设置IO2输出模式指令：EB 90 01 03 1B 01 01 21 2、下发查询指令验证是否设置成功（指令参考读取IO输出电平用例） | 1、接受应答帧：EE 16 01 02 1B 01 1F 2、设置成功
NO.38 |  | Medium | 设置IO1输出电平（低电平） | 1、待测试夹爪 2、移动电源（24V供电） 3、485转usb通讯线 4、夹爪航插通讯线 5、完成1-4接线工作（参考图1） 6、设备上电 7、连接串口工具 | 1、通过串口工具下发设置IO1输出低电平指令：EB 90 01 03 1C 00 00 20 2、下发查询指令验证是否设置成功（指令参考读取IO输出电平用例） | 1、接受应答帧：EE 16 01 02 1C 01 20 2、设置成功
NO.39 |  | Medium | 设置IO1输出电平（高电平） | 1、待测试夹爪 2、移动电源（24V供电） 3、485转usb通讯线 4、夹爪航插通讯线 5、完成1-4接线工作（参考图1） 6、设备上电 7、连接串口工具 | 1、通过串口工具下发设置IO1输出高电平指令：EB 90 01 03 1C 00 01 21 2、下发查询指令验证是否设置成功（指令参考读取IO输出电平用例） | 1、接受应答帧：EE 16 01 02 1C 01 20 2、设置成功
NO.40 |  | Medium | 设置IO2输出电平（低电平） | 1、待测试夹爪 2、移动电源（24V供电） 3、485转usb通讯线 4、夹爪航插通讯线 5、完成1-4接线工作（参考图1） 6、设备上电 7、连接串口工具 | 1、通过串口工具下发设置IO2输出低电平指令：EB 90 01 03 1C 01 00 21 2、下发查询指令验证是否设置成功（指令参考读取IO输出电平用例） | 1、接受应答帧：EE 16 01 02 1C 01 20 2、设置成功
NO.41 |  | Medium | 设置IO2输出电平（高电平） | 1、待测试夹爪 2、移动电源（24V供电） 3、485转usb通讯线 4、夹爪航插通讯线 5、完成1-4接线工作（参考图1） 6、设备上电 7、连接串口工具 | 1、通过串口工具下发设置IO2输出高电平指令：EB 90 01 03 1C 01 01 22 2、下发查询指令验证是否设置成功（指令参考读取IO输出电平用例） | 1、接受应答帧：EE 16 01 02 1C 01 20 2、设置成功
NO.42 |  | Medium | 读取IO输出电平（IO1输出高电平，IO2输出低电平） | 1、待测试夹爪 2、移动电源（24V供电） 3、485转usb通讯线 4、夹爪航插通讯线 5、完成1-4接线工作（参考图1） 6、设备上电 7、连接串口工具 | 1、通过串口工具下发读取IO输出电平指令：EB 90 01 01 1D 1F | 1、接受应答帧：EE 16 01 05 1D 01 01 01 00 26
NO.43 |  | Medium | 读取夹爪状态（可参考睿尔曼两指平行夹爪用户手册） | 1、待测试夹爪 2、移动电源（24V供电） 3、485转usb通讯线 4、夹爪航插通讯线 5、完成1-4接线工作（参考图1） 6、设备上电 7、连接串口工具 | 1、通过串口工具下发读取夹爪状态指令：EB 90 01 01 41 43 2、检查指令是否与夹爪实际状态对应 | 1、接受应答帧：EE 16 01 08 41 03 00 2C 01 00 0A 00 84 2、通过
NO.44 |  | Medium | 读取夹爪系统参数（可参考睿尔曼两指平行夹爪用户手册） | 1、待测试夹爪 2、移动电源（24V供电） 3、485转usb通讯线 4、夹爪航插通讯线 5、完成1-4接线工作（参考图1） 6、设备上电 7、连接串口工具 | 1、通过串口工具下发读取夹爪状态指令：EB 90 01 01 42 44 2、检查指令是否与夹爪实际状态对应 | 1、接受应答帧：EE 16 01 0F 42 01 04 00 00 E8 03 2C 01 E8 03 67 00 41 6C 6E 2、通过
NO.45 |  | Medium | 查询夹爪电机状态 | 1、待测试夹爪 2、移动电源（24V供电） 3、485转usb通讯线 4、夹爪航插通讯线 5、完成1-4接线工作（参考图1） 6、设备上电 7、连接串口工具 | 1、通过串口工具下发读取夹爪状态指令：EB 90 01 01 43 45 2、检查指令是否与夹爪实际状态对应 | 1、接受应答帧：EE 16 01 1F 43 01 02 00 00 52 30 25 44 00 00 B8 41 4B 59 06 3C 00 00 00 00 00 00 86 42 00 00 25 44 00 00 61 2、通过
NO.46 |  | Medium | 设置开口度（0） | 1、待测试夹爪 2、移动电源（24V供电） 3、485转usb通讯线 4、夹爪航插通讯线 5、完成1-4接线工作（参考图1） 6、设备上电 7、连接串口工具 | 1、通过串口工具下发设置夹爪开口度为0指令：EB 90 01 03 54 00 00 58 2、检查指令是否与夹爪实际状态对应 | 1、接受应答帧：EE 16 01 02 54 01 58 2、通过
NO.47 |  | Medium | 设置开口度（500） | 1、待测试夹爪 2、移动电源（24V供电） 3、485转usb通讯线 4、夹爪航插通讯线 5、完成1-4接线工作（参考图1） 6、设备上电 7、连接串口工具 | 1、通过串口工具下发设置夹爪开口度为0指令：EB 90 01 03 54 F4 01 4D 2、检查指令是否与夹爪实际状态对应 | 1、接受应答帧：EE 16 01 02 54 01 58 2、通过
NO.48 |  | Medium | 设置开口度（1000） | 1、待测试夹爪 2、移动电源（24V供电） 3、485转usb通讯线 4、夹爪航插通讯线 5、完成1-4接线工作（参考图1） 6、设备上电 7、连接串口工具 | 1、通过串口工具下发设置夹爪开口度为0指令：EB 90 01 03 54 E8 03 43 2、检查指令是否与夹爪实际状态对应 | 1、接受应答帧：EE 16 01 02 54 01 58 2、通过
NO.49 |  | Medium | 查询当前开口度（999时） | 1、待测试夹爪 2、移动电源（24V供电） 3、485转usb通讯线 4、夹爪航插通讯线 5、完成1-4接线工作（参考图1） 6、设备上电 7、连接串口工具 | 1、通过串口工具下发查询夹爪开口指令：EB 90 01 01 D9 DB 2、检查指令是否与夹爪实际状态对应 | 1、接受应答帧：EE 16 01 03 D9 E7 03 C7 2、通过
NO.50 |  | Medium | 设置IO控制使能（打开） | 1、待测试夹爪 2、移动电源（24V供电） 3、485转usb通讯线 4、夹爪航插通讯线 5、完成1-4接线工作（参考图1） 6、设备上电 7、连接串口工具 | 1、通过串口工具下发查询夹爪开口指令：EB 90 01 02 DA 01 DE 2、检查指令是否与夹爪实际状态对应 | 1、接受应答帧：EE 16 01 02 54 01 58 2、通过
NO.51 |  | Medium | 设置IO控制使能（关闭） | 1、待测试夹爪 2、移动电源（24V供电） 3、485转usb通讯线 4、夹爪航插通讯线 5、完成1-4接线工作（参考图1） 6、设备上电 7、连接串口工具 | 1、通过串口工具下发查询夹爪开口指令：EB 90 01 02 DA 00 DD 2、检查指令是否与夹爪实际状态对应 | 1、接受应答帧：EE 16 01 02 54 01 58 2、通过
NO.52 |  | Medium | 设置零位（开口度为0时） | 1、待测试夹爪 2、移动电源（24V供电） 3、485转usb通讯线 4、夹爪航插通讯线 5、完成1-4接线工作（参考图1） 6、设备上电 7、连接串口工具 | 1、通过串口工具下发设置零位指令：EB 90 01 01 DB DD 2、下发夹爪开合指令，观察夹爪实际零位是否修改 | 1、接受应答帧：EE 16 01 02 DB 01 DF 2、通过
NO.53 |  | Medium | 设置零位（开口度为500时） | 1、待测试夹爪 2、移动电源（24V供电） 3、485转usb通讯线 4、夹爪航插通讯线 5、完成1-4接线工作（参考图1） 6、设备上电 7、连接串口工具 | 1、通过串口工具下发设置零位指令：EB 90 01 01 DB DD 2、下发夹爪开合指令，观察夹爪实际零位是否修改 | 1、接受应答帧：EE 16 01 02 DB 01 DF 2、通过
NO.54 |  | Medium | 设置零位（开口度为1000时） | 1、待测试夹爪 2、移动电源（24V供电） 3、485转usb通讯线 4、夹爪航插通讯线 5、完成1-4接线工作（参考图1） 6、设备上电 7、连接串口工具 | 1、通过串口工具下发设置零位指令：EB 90 01 01 DB DD 2、下发夹爪开合指令，观察夹爪实际零位是否修改 | 1、接受应答帧：EE 16 01 02 DB 01 DF 2、通过
NO.55 |  | Medium | 以设置的速度256、力控50、开口度0夹取 | 1、待测试夹爪 2、移动电源（24V供电） 3、485转usb通讯线 4、夹爪航插通讯线 5、完成1-4接线工作（参考图1） 6、设备上电 7、连接串口工具 | 1、通过串口工具下发设置零位指令：EB 90 01 07 E5 01 00 32 00 00 00 20 2、观察夹爪运动状态是否符合指令 | 1、接受应答帧：无 2、通过
NO.56 |  | Medium | 以设置的速度500、力控500、开口度500夹取 | 1、待测试夹爪 2、移动电源（24V供电） 3、485转usb通讯线 4、夹爪航插通讯线 5、完成1-4接线工作（参考图1） 6、设备上电 7、连接串口工具 | 1、通过串口工具下发设置零位指令：EB 90 01 07 E5 F4 01 F4 01 F4 01 CC 2、观察夹爪运动状态是否符合指令 | 1、接受应答帧：无 2、通过
NO.57 |  | Medium | 以设置的速度1000、力控1000、开口度1000夹取 | 1、待测试夹爪 2、移动电源（24V供电） 3、485转usb通讯线 4、夹爪航插通讯线 5、完成1-4接线工作（参考图1） 6、设备上电 7、连接串口工具 | 1、通过串口工具下发设置零位指令：EB 90 01 07 E5 E8 03 E8 03 E8 03 AE 2、观察夹爪运动状态是否符合指令 | 1、接受应答帧：无 2、通过

Sheet: 功能测试
序号 | 模块 | 优先级 | 概要 | 描述 | 前提条件 | 步骤 | 预期结果 | 执行结果
NO.1 | 两指平行夹爪 | Medium | 打开 | 正常 | 1、上位机与夹爪控制系统之间的通信已正确建立 2、夹爪为工作状态 | 1、下发打开指令 | 1、夹爪应在接收到指令后按照规定速度开始打开 2、夹爪在规定时间内达到夹爪最大开口尺寸 3、上位机接收到来自夹爪控制系统的反馈，表明夹爪已成功松开到最大开口位置
NO.2 | 两指平行夹爪 | Medium | 闭合 | 正常 | 1、上位机与夹爪控制系统之间的通信已正确建立 2、夹爪为工作状态 | 1、下发闭合指令 | 1、夹爪应在接收到指令后按照规定速度开始闭合 2、夹爪在规定时间内达到夹爪最小闭合尺寸。 3、上位机应能接收到来自控制系统的反馈，表明夹爪已成功闭合到最小闭合位置。
NO.3 | 两指平行夹爪 | Medium | 位置控制 | 正常 | 1、Aloha系统已正确安装并配置，包括两指平行夹爪及其控制系统。 2、上位机与控制系统之间的通信已建立并正常工作。 3、夹爪处于初始状态，即非夹持状态，且开口尺寸大于目标尺寸。 | 1、在上位机软件中输入目标开口尺寸 2、通过上位机软件发送控制夹爪开合到指定尺寸的指令 3、使用视觉检查或传感器监测夹爪的开合变化，特别注意主动夹爪和从动夹爪的动作是否协调一致。 4、使用测量工具（如尺子、游标卡尺等）验证夹爪的实际开口尺寸是否与目标尺寸相符 | 1、夹爪在接收到指令后应开始动作，主动夹爪和从动夹爪应同步开合。 2、夹爪应在合理的时间内稳定地达到目标开口尺寸，且误差在可接受范围内。 3、上位机应能接收到来自控制系统的反馈，表明夹爪已成功达到目标尺寸。
NO.4 | 两指平行夹爪 | Medium | 透传控制 | 正常-基本开合功能 | 1、建立上层RS485和夹爪之间通信 2、夹爪为工作状态 | 1、发送打开夹爪到最大开口的指令。 2、等待夹爪动作完成。 3、验证夹爪是否已打开到最大开口位置。 4、发送闭合夹爪到最小闭合的指令。 5、等待夹爪动作完成。 6、验证夹爪是否已闭合到最小闭合位置 | 1、夹爪能够准确响应指令，并达到预期的开口/闭合位置。
NO.5 | 两指平行夹爪 | Medium |  | 正常-目标尺寸控制 | 1、建立上层RS485和夹爪之间通信 2、夹爪为工作状态 | 1、发送控制夹爪开合到指定目标尺寸的指令。 2、等待夹爪动作完成。 3、使用测量工具验证夹爪的实际开口尺寸是否与目标尺寸相符（允许一定范围内的误差）。 | 1、夹爪能够准确达到或接近指定的目标尺寸。
NO.6 | 两指平行夹爪 | Medium |  | 正常-连续指令 | 1、建立上层RS485和夹爪之间通信 2、夹爪为工作状态 | 1、连续发送多个开合指令。 2、观察夹爪是否按顺序执行每个指令。 3、验证每个指令执行后的夹爪状态是否正确 | 1、夹爪能够连续、准确地响应每个指令。
NO.7 | 两指平行夹爪 | Medium |  | 异常处理 | 1、建立上层RS485和夹爪之间通信 2、夹爪为工作状态 | 1、发送一个无效指令。 2、观察系统是否报错或忽略无效指令。 3、发送一个有效指令，验证系统是否恢复正常。 | 1、系统应能识别并处理无效指令，不会因此影响后续的有效指令执行。
NO.8 | 两指平行夹爪 | Medium |  | 通信中断恢复 | 1、建立上层RS485和夹爪之间通信 2、夹爪为工作状态 | 1、在夹爪执行指令过程中模拟通信中断。 2、等待一段时间后重新建立通信连接。 3、发送新的控制指令。 4、观察夹爪是否响应新指令。 | 1、通信恢复后，系统应能继续接收并执行新的控制指令。
NO.9 | 两指平行夹爪 | Medium | 电流保护 | 额定电流下夹持力 | 1、额定电流为0.8A。 2、放置一个已知质量的物体（如3.5kg的标准砝码）供夹爪抓取。 | 1、上位机发送指令，使夹爪闭合并抓取物体。 2、观察并记录夹爪的电流输出是否稳定在0.8A左右。 3、使用适当的测量工具（如测力计）验证夹爪对物体的夹持力是否约为3.5kg。 | 1、夹爪电流稳定在0.8A，夹持力约为3.5kg。
NO.10 | 两指平行夹爪 | Medium |  | 电流限制 | 1、额定电流为0.8A。 2、放置一个超出3.5kg的物体（如5kg的标准砝码）供夹爪抓取。 | 1、上位机发送指令，使夹爪尝试抓取较重的物体。 2、观察并记录夹爪的电流输出是否在达到0.8A后保持稳定，不再继续增加。 3、验证夹爪是否仍能保持对物体的夹持 | 1、夹爪电流在达到0.8A后保持稳定，不继续增加，且夹爪仍能保持对物体的夹持
NO.11 | 两指平行夹爪 | Medium |  | 上位机电流设置 | 1、上位机软件，用于设置夹爪的电流上限。 2、准备不同质量的物体进行测试。 | 1、在上位机软件中设置不同的电流上限值（如0.8A、1.2A、1.6A等，但不超过2.4A）。 2、对于每个设置值，发送指令使夹爪抓取适当质量的物体。 3、观察并记录夹爪的电流输出是否符合设置值，并验证夹持力是否相应变化。 | 1、夹爪的电流输出与上位机设置的电流上限一致，且夹持力随电流变化而相应变化。
NO.12 | 两指平行夹爪 | Medium |  | 电流过载保护 | 1、准备一个远超夹爪额定夹持力的重物。 2、上位机设置夹爪的电流上限为最大允许值（2.4A）。 | 1、尝试让夹爪抓取远超其额定夹持力的重物。 2、观察并记录夹爪的电流输出是否达到并保持在设置的电流上限（2.4A），且不再继续增加。 3、检查夹爪和电机是否有过热、损坏等迹象。 | 1、夹爪电流在达到2.4A后保持稳定，不继续增加，且夹爪和电机未受损坏。
NO.13 | 两指平行夹爪 | Medium | 零位校准 | 正常 | 1、上位机软件，能够发送控制指令并接收手爪状态反馈。 2、夹爪已上电并保持在任意初始位置 | 1、上位机下发零位校准命令 | 1、手爪能够响应闭合指令并正确闭合。 2、闭合过程中电流变化符合预期，且能够准确检测到闭合条件。 3、手爪的零位能够正确设置，并在后续操作中准确回到该位置
NO.14 | 两指平行夹爪 | Medium | 急停 | 正常 | 1、上位机软件，能够发送控制指令和急停指令。 2、夹爪正在执行开合或其他运动。 | 1、上位机下发急停命令 | 1、夹爪在接收到急停指令后能够立即停止当前的运动。 2、夹爪保持在停止时的位置不动，不会因惯性或其他原因继续移动。
NO.15 | 两指平行夹爪 | Medium | 故障消除 | 内部通信故障清除 | 1、上位机与夹爪控制系统之间的通信已正确建立 2、夹爪为工作状态 | 1、模拟夹爪内部通信故障（如断开通信线、模拟通信协议错误等）。 2、确认夹爪因通信故障而停止工作，并显示相应的故障信息。 3、通过上位机发送内部通信故障清除指令。 4、观察夹爪是否恢复通信并重新开始工作。 5、检查上位机是否接收到故障已清除的确认信息。 | 1、夹爪恢复通信并正常工作，上位机收到故障已清除的确认信息。
NO.16 | 两指平行夹爪 | Medium |  | 关节驱动器故障清除 | 1、上位机与夹爪控制系统之间的通信已正确建立 2、夹爪为工作状态 | 1、模拟关节驱动器故障（如驱动器过热、电源故障等）。 2、确认夹爪因驱动器故障而停止工作，并显示相应的故障信息。 3、通过上位机发送关节驱动器故障清除指令（如果适用）。 4、观察夹爪是否恢复驱动器功能并重新开始工作。 5、如果故障无法直接清除，检查夹爪是否进入待机模式并等待维修。 6、检查上位机是否接收到故障清除结果或故障状态报告。 | 1、如果故障可清除，夹爪恢复工作；如果不可清除，夹爪进入待机模式，上位机收到故障状态报告
NO.17 | 两指平行夹爪 | Medium |  | 过流故障清除 | 1、上位机与夹爪控制系统之间的通信已正确建立 2、夹爪为工作状态 | 1、模拟过流故障（如短路、负载过大等）。 2、确认夹爪因过流而停止工作，并显示相应的故障信息。 3、通过上位机发送过流故障清除指令（通常包括重置保护机制）。 4、观察夹爪是否恢复正常工作。 5、检查上位机是否接收到故障清除的确认信息。 | 1、夹爪恢复正常工作，上位机收到故障已清除的确认信息
NO.18 | 两指平行夹爪 | Medium |  | 过温故障自动恢复 | 1、上位机与夹爪控制系统之间的通信已正确建立 2、夹爪为工作状态 | 1、使夹爪处于高温环境（如加热元件或使用外部热源），使其温度超过90摄氏度。 2、确认夹爪因过温而停止工作，并显示相应的故障信息。 3、等待夹爪自然冷却至低于60摄氏度。 4、观察夹爪是否自动恢复正常工作。 5、检查上位机是否接收到夹爪已恢复工作的确认信息（如果系统支持）。 | 1、夹爪在温度降低到安全范围后自动恢复工作，上位机（如果支持）收到恢复工作的确认信息
NO.19 | 两指平行夹爪 | Medium |  | 堵转故障清除 | 1、上位机与夹爪控制系统之间的通信已正确建立 2、夹爪为工作状态 | 1、模拟夹爪堵转情况（如夹持物体过大、机械部件卡死等）。 2、确认夹爪因堵转而停止工作，并显示相应的故障信息。 3、解决堵转问题（如移除过大物体、修复机械部件等）。 4、通过上位机发送堵转故障清除指令（如果适用）。 5、观察夹爪是否恢复正常工作。 6、检查上位机是否接收到故障清除的确认信息。 | 1、夹爪恢复正常工作，上位机收到故障已清除的确认信息
NO.20 | 两指平行夹爪 | Medium |  | 无法清除故障 | 1、上位机与夹爪控制系统之间的通信已正确建立 2、夹爪为工作状态 | 1、模拟一个无法直接通过清除指令解决的故障（如严重硬件损坏）。 2、尝试通过上位机发送故障清除指令。 3、观察夹爪是否仍然处于故障状态。 4、检查上位机是否接收到夹爪的故障状态报告，包括故障类型和详细信息。 | 1、夹爪保持故障状态，上位机收到详细的故障状态报告。
NO.21 |  | Medium | 高跟随功能 | 正常 | 1、夹爪预热、初始化完成 2、通信正常，无延迟或丢包现象 | 1、在控制软件中设置手爪的控制周期为9ms（或其他小于10ms的值）。 2、启动一个简单的跟随任务，如打开、闭合、急停等 3、使用高精度的时间测量工具（如示波器或软件计时器）记录手爪的实际控制周期。 4、重复测试多次，以验证控制周期的稳定性和一致性。 | 1、控制周期稳定在9ms左右（或设定的其他小于10ms的值），无显著波动。
NO.22 | 两指平行夹爪 | Medium | 异常场景 | 异常-通信异常-上位机发送错误指令 | 1、上位机与夹爪控制系统之间的通信已正确建立 2、夹爪为工作状态 | 1、上位机下发打开、闭合、位置控制、零位校准、急停等命令 | 1、夹爪无反馈/夹爪工作异常/夹爪工作不符合预期
NO.23 |  |  |  | 异常-通信异常-CAN线通信异常 | 1、上位机与夹爪控制系统之间的通信已正确建立 2、夹爪为工作状态 | 1、上位机下发打开、闭合、位置控制、零位校准、急停等命令 | 1、夹爪无反馈/夹爪工作异常/夹爪工作不符合预期
NO.24 |  |  |  | 异常-通信异常-夹爪内部电气故障 | 1、上位机与夹爪控制系统之间的通信已正确建立 2、夹爪为工作状态 | 1、上位机下发打开、闭合、位置控制、零位校准、急停等命令 | 1、夹爪无反馈/夹爪工作异常/夹爪工作不符合预期
NO.25 |  |  |  | 异常-通信异常-夹爪机械故障 | 1、上位机与夹爪控制系统之间的通信已正确建立 2、夹爪为工作状态 | 1、上位机下发打开、闭合、位置控制、零位校准、急停等命令 | 1、夹爪无反馈/夹爪工作异常/夹爪工作不符合预期
NO.26 |  |  |  | 异常-通信异常-夹爪夹指存在物理阻碍 | 1、上位机与夹爪控制系统之间的通信已正确建立 2、夹爪为工作状态 | 1、上位机下发打开、闭合、位置控制、零位校准、急停等命令 | 1、夹爪无反馈/夹爪工作异常/夹爪工作不符合预期
NO.27 | 两指平行夹爪 | Medium | 夹取场景测试 | 夹取木质物体 | 1、上位机与夹爪控制系统之间的通信已正确建立 2、夹爪为工作状态 | 1、上位机设置适当的力与速度（最大力、最小力、适当力） 2、下发单次夹取/持续夹取指令 3、观察夹爪夹取物体后状态 | 1、夹取成功
NO.28 | 两指平行夹爪 | Medium |  | 夹取塑质物体 | 1、上位机与夹爪控制系统之间的通信已正确建立 2、夹爪为工作状态 | 1、上位机设置适当的力与速度（最大力、最小力、适当力） 2、下发单次夹取/持续夹取指令 3、观察夹爪夹取物体后状态 | 1、夹取成功
NO.29 | 两指平行夹爪 | Medium |  | 夹取塑质物体 | 1、上位机与夹爪控制系统之间的通信已正确建立 2、夹爪为工作状态 | 1、上位机设置适当的力与速度（最大力、最小力、适当力） 2、下发单次夹取/持续夹取指令 3、观察夹爪夹取物体后状态 | 1、夹取成功
NO.30 | 两指平行夹爪 | Medium |  | 夹取金属物体 | 1、上位机与夹爪控制系统之间的通信已正确建立 2、夹爪为工作状态 | 1、上位机设置适当的力与速度（最大力、最小力、适当力） 2、下发单次夹取/持续夹取指令 3、观察夹爪夹取物体后状态 | 1、夹取成功
NO.31 | 两指平行夹爪 | Medium |  | 夹取其他物体（纸杯、水果、面包） | 1、上位机与夹爪控制系统之间的通信已正确建立 2、夹爪为工作状态 | 1、上位机设置适当的力与速度（最大力、最小力、适当力） 2、下发单次夹取/持续夹取指令 3、观察夹爪夹取物体后状态 | 1、夹取失败。（夹取物品出现变形，破碎现象）

Sheet: 性能测试
序号 | 模块 | 优先级 | 概要 | 描述 | 前提条件 | 步骤 | 预期结果 | 执行结果
NO.1 | 两指平行夹爪 | Medium | 温度适应性 | 0度以上（27°）环境 | 1、搭建测试环境，包括温控箱和湿度控制室。 2、准备温度监测设备和湿度计。 3、确保夹爪处于良好工作状态，无外部损伤或故障。 | 1、将夹爪置于温控箱中，设置温度为0℃，持续运行24小时。记录运行过程中的任何异常现象，如卡顿、停止、过热等。 | 1、夹爪工作无异常（电流、电压、温度（内部和外部）、响应时间等都处于正常范围）
NO.2 | 两指平行夹爪 | Medium | 温度适应性 | 50度环境以下（27°） | 1、搭建测试环境，包括温控箱和湿度控制室。 2、准备温度监测设备和湿度计。 3、确保夹爪处于良好工作状态，无外部损伤或故障。 | 1、将夹爪置于温控箱中，设置温度为50℃，持续运行24小时。记录运行过程中的任何异常现象，如卡顿、停止、过热等。 | 1、夹爪工作无异常（电流、电压、温度（内部和外部）、响应时间等都处于正常范围）
NO.3 | 两指平行夹爪 | Medium | 温度适应性 | 50度以上环境 | 1、搭建测试环境，包括温控箱和湿度控制室。 2、准备温度监测设备和湿度计。 3、确保夹爪处于良好工作状态，无外部损伤或故障。 | 1、将夹爪置于温控箱中，设置温度为65℃，持续运行24小时。记录运行过程中的任何异常现象，如卡顿、停止、过热等。 | 1、夹爪可能出现功能失效、性能下降或物理损坏的迹象
NO.4 | 两指平行夹爪 | Medium | 湿度适应性 | 85%RH以下环境（50%RH） | 1、搭建测试环境，包括温控箱和湿度控制室。 2、准备温度监测设备和湿度计。 3、确保夹爪处于良好工作状态，无外部损伤或故障。 | 1、在湿度控制室中，将湿度调节至85%RH以下，结合上述温度测试条件进行 | 1、夹爪工作无异常（无受潮）（电流、电压、温度（内部和外部）、响应时间等都处于正常范围）
NO.5 | 两指平行夹爪 | Medium | 湿度适应性 | 85%RH以上环境 | 1、搭建测试环境，包括温控箱和湿度控制室。 2、准备温度监测设备和湿度计。 3、确保夹爪处于良好工作状态，无外部损伤或故障。 | 1、在湿度控制室中，将湿度调节至85%RH以上，结合上述温度测试条件进行 | 1、夹爪可能出现受潮、短路、功能失效、性能下降或物理损坏的迹象
NO.6 | 两指平行夹爪 | Medium | 供电 | 最大电流（2.4A） | 1、确保夹爪处于良好工作状态，无外部损伤或故障。 | 1、2.4A+控制板电流给夹爪24h供电，记录运行过程中的任何异常现象，如卡顿、停止、过热等。 | 1、夹爪可能出现过热迹象
NO.7 | 两指平行夹爪 | Medium | 供电 | 超出最大电流（5A） | 1、确保夹爪处于良好工作状态，无外部损伤或故障。 | 1、≥3A电流给夹爪供电，记录运行过程中的任何异常现象，如卡顿、停止、过热等。 | 1、夹爪可能出现过热、短路等迹象
NO.8 | 两指平行夹爪 | Medium | 长时间运行稳定性 | 48h | 1、确保夹爪处于良好工作状态，无外部损伤或故障。 | 1、将设备设置为连续工作模式，并运行48h | 1、夹爪工作无异常（电流、电压、温度（内部和外部）、响应时间等都处于正常范围）
NO.9 | 两指平行夹爪 | Medium | 长时间运行稳定性 | 7*24h | 1、确保夹爪处于良好工作状态，无外部损伤或故障。 | 1、将设备设置为连续工作模式，并运行7*24h | 1、夹爪工作无异常（电流、电压、温度（内部和外部）、响应时间等都处于正常范围）
NO.10 | 两指平行夹爪 | Medium | 掉电缓冲 | 断电 | 1、确保夹爪处于良好工作状态，无外部损伤或故障。 | 1、在设备正常工作时，突然切断电源。 2、观察并记录设备掉电后的状态，如夹爪是否缓慢张开或保持在当前位置 | 1、设备掉电后的状态，夹爪缓慢张开或保持在当前位置
NO.11 | 两指平行夹爪 | Medium | 振动和冲击 | 模拟设备在运输和使用过程中可能遇到的振动和冲击条件。 | 1、确保夹爪状态完好，无外部损伤或故障。 | 1、使用振动台对设备进行振动测试，设置适当的频率和振幅以模拟实际环境中的振动条件。 2、对设备进行冲击测试，模拟跌落、碰撞等意外情况 | 1、夹爪受轻微磕碰后仍能继续工作
NO.12 | 两指平行夹爪 | Medium | 电磁兼容性 | 设备在电磁干扰环境下的工作稳定性和抗干扰能力 | 1、确保夹爪处于良好工作状态，无外部损伤或故障。 | 1、将设备置于电磁辐射环境中，使用电磁辐射源模拟电磁干扰场景。 2、监测并记录设备在电磁干扰下的运行状态和性能变化。
NO.13 | 两指平行夹爪 | Medium | 最大负载 | 5kg负载 | 1、确保夹爪处于良好工作状态，无外部损伤或故障。 | 1、使用夹爪夹住5kg圆形砝码 2、记录静态夹持时间 | 1、夹爪可以静态夹持5kg重物并保持5min
NO.14 | 两指平行夹爪 | Medium | 极限负载 | 5kg以上负载 | 1、确保夹爪处于良好工作状态，无外部损伤或故障。 | 1、使用夹爪夹住5kg-∞圆形砝码 2、记录静态夹持时间 | 1、记录夹爪可夹持最大重物和时间

Sheet: 协议测试
序号 | 模块 | 优先级 | 概要 | 前提条件 | 步骤 | 预期结果 | 执行结果
NO.1 | 自研两指夹爪485协议 | Medium | 保存参数 | 1、待测试夹爪 2、移动电源（24V供电） 3、485转usb通讯线 4、夹爪航插通讯线 5、完成1-4接线工作（参考图1） 6、设备上电 7、连接串口工具 | 1、通过串口工具下发保存参数指令：EB 90 01 01 01 03 | 1、接受应答帧：EE 16 01 02 01 01 05
NO.2 | 自研两指夹爪485协议 | Medium | 系统恢复默认参数 | 1、待测试夹爪 2、移动电源（24V供电） 3、485转usb通讯线 4、夹爪航插通讯线 5、完成1-4接线工作（参考图1） 6、设备上电 7、连接串口工具 | 1、随机修改系统参数（参考下方用例） 2、通过串口工具下发恢复默认参数指令：EB 90 01 01 02 04 3、断电重启设备 4、设备上电后，上位机查询系统参数 | 2、接受应答帧：EE 16 01 02 02 01 06 4、系统参数恢复默认
NO.3 | 自研两指夹爪485协议 | Medium | 设置波特率为9600 | 1、待测试夹爪 2、移动电源（24V供电） 3、485转usb通讯线 4、夹爪航插通讯线 5、完成1-4接线工作（参考图1） 6、设备上电 7、连接串口工具 | 1、通过串口工具下发设置波特率为9600指令：EB 90 01 02 03 00 06 2、通过串口工具下发保存参数指令：EB 90 01 01 01 03 3、断电重启设备 4、设备上电后，上位机查询波特率 | 1、接受应答帧：EE 16 01 02 03 01 07 2、接受应答帧：EE 16 01 02 01 01 05 3、波特率已修改为9600
NO.4 | 自研两指夹爪485协议 | Medium | 设置波特率为19200 | 1、待测试夹爪 2、移动电源（24V供电） 3、485转usb通讯线 4、夹爪航插通讯线 5、完成1-4接线工作（参考图1） 6、设备上电 7、连接串口工具 | 1、通过串口工具下发设置波特率为19200指令：EB 90 01 02 03 01 07 2、通过串口工具下发保存参数指令：EB 90 01 01 01 03 3、断电重启设备 4、设备上电后，上位机查询波特率 | 1、接受应答帧：EE 16 01 02 03 01 07 2、接受应答帧：EE 16 01 02 01 01 05 3、波特率已修改为19200
NO.5 | 自研两指夹爪485协议 | Medium | 设置波特率为38400 | 1、待测试夹爪 2、移动电源（24V供电） 3、485转usb通讯线 4、夹爪航插通讯线 5、完成1-4接线工作（参考图1） 6、设备上电 7、连接串口工具 | 1、通过串口工具下发设置波特率为38400指令：EB 90 01 02 03 02 08 2、通过串口工具下发保存参数指令：EB 90 01 01 01 03 3、断电重启设备 4、设备上电后，上位机查询波特率 | 1、接受应答帧：EE 16 01 02 03 01 07 2、接受应答帧：EE 16 01 02 01 01 05 3、波特率已修改为38400
NO.6 | 自研两指夹爪485协议 | Medium | 设置波特率为57600 | 1、待测试夹爪 2、移动电源（24V供电） 3、485转usb通讯线 4、夹爪航插通讯线 5、完成1-4接线工作（参考图1） 6、设备上电 7、连接串口工具 | 1、通过串口工具下发设置波特率为57600指令：EB 90 01 02 03 03 09 2、通过串口工具下发保存参数指令：EB 90 01 01 01 03 3、断电重启设备 4、设备上电后，上位机查询波特率 | 1、接受应答帧：EE 16 01 02 03 01 07 2、接受应答帧：EE 16 01 02 01 01 05 3、波特率已修改为57600
NO.7 | 自研两指夹爪485协议 | Medium | 设置波特率为115200 | 1、待测试夹爪 2、移动电源（24V供电） 3、485转usb通讯线 4、夹爪航插通讯线 5、完成1-4接线工作（参考图1） 6、设备上电 7、连接串口工具 | 1、通过串口工具下发设置波特率为57600指令：EB 90 01 02 03 04 0A 2、通过串口工具下发保存参数指令：EB 90 01 01 01 03 3、断电重启设备 4、设备上电后，上位机查询波特率 | 1、接受应答帧：EE 16 01 02 03 01 07 2、接受应答帧：EE 16 01 02 01 01 05 3、波特率已修改为115200
NO.8 | 自研两指夹爪485协议 | Medium | 设置波特率为460800 | 1、待测试夹爪 2、移动电源（24V供电） 3、485转usb通讯线 4、夹爪航插通讯线 5、完成1-4接线工作（参考图1） 6、设备上电 7、连接串口工具 | 1、通过串口工具下发设置波特率为57600指令：EB 90 01 02 03 05 0B 2、通过串口工具下发保存参数指令：EB 90 01 01 01 03 3、断电重启设备 4、设备上电后，上位机查询波特率 | 1、接受应答帧：EE 16 01 02 03 01 07 2、接受应答帧：EE 16 01 02 01 01 05 3、波特率已修改为460800
NO.9 | 自研两指夹爪485协议 | Medium | 设置夹爪id为1 | 1、待测试夹爪 2、移动电源（24V供电） 3、485转usb通讯线 4、夹爪航插通讯线 5、完成1-4接线工作（参考图1） 6、设备上电 7、连接串口工具 | 1、通过串口工具下发设置夹爪ID为1指令：EB 90 01 02 04 01 08 2、通过串口工具下发保存参数指令：EB 90 01 01 01 03 3、断电重启设备 4、设备上电后，上位机查询夹爪ID | 1、接受应答帧：EE 16 01 02 04 01 08 2、接受应答帧：EE 16 01 02 01 01 05 3、夹爪ID已设置为1
NO.10 | 自研两指夹爪485协议 | Medium | 设置夹爪id为7 | 1、待测试夹爪 2、移动电源（24V供电） 3、485转usb通讯线 4、夹爪航插通讯线 5、完成1-4接线工作（参考图1） 6、设备上电 7、连接串口工具 | 1、通过串口工具下发设置夹爪ID为1指令：EB 90 01 02 04 07 0E 2、通过串口工具下发保存参数指令：EB 90 01 01 01 03 3、断电重启设备 4、设备上电后，上位机查询夹爪ID | 1、接受应答帧：EE 16 01 02 04 01 08 2、接受应答帧：EE 16 01 02 01 01 05 3、夹爪ID已设置为7
NO.11 | 自研两指夹爪485协议 | Medium | 设置夹爪id为21 | 1、待测试夹爪 2、移动电源（24V供电） 3、485转usb通讯线 4、夹爪航插通讯线 5、完成1-4接线工作（参考图1） 6、设备上电 7、连接串口工具 | 1、通过串口工具下发设置夹爪ID为1指令：EB 90 01 02 04 15 1C 2、通过串口工具下发保存参数指令：EB 90 01 01 01 03 3、断电重启设备 4、设备上电后，上位机查询夹爪ID | 1、接受应答帧：EE 16 01 02 04 01 08 2、接受应答帧：EE 16 01 02 01 01 05 3、夹爪ID已设置为21
NO.12 | 自研两指夹爪485协议 | Medium | 设置夹爪id为35 | 1、待测试夹爪 2、移动电源（24V供电） 3、485转usb通讯线 4、夹爪航插通讯线 5、完成1-4接线工作（参考图1） 6、设备上电 7、连接串口工具 | 1、通过串口工具下发设置夹爪ID为1指令：EB 90 01 02 04 23 2A 2、通过串口工具下发保存参数指令：EB 90 01 01 01 03 3、断电重启设备 4、设备上电后，上位机查询夹爪ID | 1、接受应答帧：EE 16 01 02 04 01 08 2、接受应答帧：EE 16 01 02 01 01 05 3、夹爪ID已设置为35
NO.13 | 自研两指夹爪485协议 | Medium | 查询夹爪ID | 1、待测试夹爪 2、移动电源（24V供电） 3、485转usb通讯线 4、夹爪航插通讯线 5、完成1-4接线工作（参考图1） 6、设备上电 7、连接串口工具 | 1、通过串口工具下发查询夹爪ID指令：EB 90 FF 01 05 05 | 1、设备ID为1时应答帧：EE 16 01 02 05 01 09
NO.14 | 自研两指夹爪485协议 | Medium | 以设置的速度300和力控200夹取 | 1、待测试夹爪 2、移动电源（24V供电） 3、485转usb通讯线 4、夹爪航插通讯线 5、完成1-4接线工作（参考图1） 6、设备上电 7、连接串口工具 | 1、通过串口工具下发以力矩为200，速度为300单次夹取指令：EB 90 01 05 18 2C 01 C8 00 13 | 1、接受应答帧：EE 16 01 02 18 01 1C
NO.15 | 自研两指夹爪485协议 | Medium | 以设置的速度1和力控50夹取 | 1、待测试夹爪 2、移动电源（24V供电） 3、485转usb通讯线 4、夹爪航插通讯线 5、完成1-4接线工作（参考图1） 6、设备上电 7、连接串口工具 | 1、通过串口工具下发以力矩为50，速度为1单次夹取指令：EB 90 01 05 18 01 00 32 00 51 | 1、接受应答帧：EE 16 01 02 18 01 1C
NO.16 | 自研两指夹爪485协议 | Medium | 以设置的速度500和力控500夹取 | 1、待测试夹爪 2、移动电源（24V供电） 3、485转usb通讯线 4、夹爪航插通讯线 5、完成1-4接线工作（参考图1） 6、设备上电 7、连接串口工具 | 1、通过串口工具下发以力矩为500，速度为500单次夹取指令：EB 90 01 05 18 F4 01 F4 01 08 | 1、接受应答帧：EE 16 01 02 18 01 1C
NO.17 | 自研两指夹爪485协议 | Medium | 以设置的速度1000和力控1000夹取 | 1、待测试夹爪 2、移动电源（24V供电） 3、485转usb通讯线 4、夹爪航插通讯线 5、完成1-4接线工作（参考图1） 6、设备上电 7、连接串口工具 | 1、通过串口工具下发以力矩为1000，速度为1000单次夹取指令：EB 90 01 05 18 E8 03 E8 03 F4 | 1、接受应答帧：EE 16 01 02 18 01 1C
NO.18 | 自研两指夹爪485协议 | Medium | 以设置的速度1松开 | 1、待测试夹爪 2、移动电源（24V供电） 3、485转usb通讯线 4、夹爪航插通讯线 5、完成1-4接线工作（参考图1） 6、设备上电 7、连接串口工具 | 1、通过串口工具下发以速度为1松开夹取指令：EB 90 01 03 11 01 00 16 2、观察夹爪松开速度 | 1、接受应答帧：EE 16 01 02 11 01 15 2、夹爪按照1速度松开夹爪
NO.19 | 自研两指夹爪485协议 | Medium | 以设置的速度500松开 | 1、待测试夹爪 2、移动电源（24V供电） 3、485转usb通讯线 4、夹爪航插通讯线 5、完成1-4接线工作（参考图1） 6、设备上电 7、连接串口工具 | 1、通过串口工具下发以速度为500松开夹取指令：EB 90 01 03 11 F4 01 0A 2、观察夹爪松开速度 | 1、接受应答帧：EE 16 01 02 11 01 15 2、夹爪按照500速度松开夹爪
NO.20 | 自研两指夹爪485协议 | Medium | 以设置的速度1000松开 | 1、待测试夹爪 2、移动电源（24V供电） 3、485转usb通讯线 4、夹爪航插通讯线 5、完成1-4接线工作（参考图1） 6、设备上电 7、连接串口工具 | 1、通过串口工具下发以速度为1松开夹取指令：EB 90 01 03 11 E8 03 00 2、观察夹爪松开速度 | 1、接受应答帧：EE 16 01 02 11 01 15 2、夹爪按照1000速度松开夹爪
NO.21 | 自研两指夹爪485协议 | Medium | 设置夹爪开口度限位为0-1000 | 1、待测试夹爪 2、移动电源（24V供电） 3、485转usb通讯线 4、夹爪航插通讯线 5、完成1-4接线工作（参考图1） 6、设备上电 7、连接串口工具 | 1、通过串口工具下发设置夹爪开口度为0-1000指令：EB 90 01 05 12 E8 03 00 00 03 2、下发开合夹爪指令查看夹爪开口度（指令参考上方用例） 3、下发保存指令（参考上方用例） 4、断电重启生效 5、检查是否设置成功 | 1、接受应答帧：EE 16 01 02 12 01 16 2、开口限位0-1000 5、设置成功
NO.22 | 自研两指夹爪485协议 | Medium | 设置夹爪开口度限位200-800 | 1、待测试夹爪 2、移动电源（24V供电） 3、485转usb通讯线 4、夹爪航插通讯线 5、完成1-4接线工作（参考图1） 6、设备上电 7、连接串口工具 | 1、通过串口工具下发设置夹爪开口度为200-800指令：EB 90 01 05 12 20 03 C8 00 03 2、下发开合夹爪指令查看夹爪开口度（指令参考上方用例） 3、下发保存指令（参考上方用例） 4、断电重启生效 5、检查是否设置成功 | 1、接受应答帧：EE 16 01 02 12 01 16 2、开口限位200-800 5、设置成功
NO.23 | 自研两指夹爪485协议 | Medium | 设置夹爪开口度限位400-600 | 1、待测试夹爪 2、移动电源（24V供电） 3、485转usb通讯线 4、夹爪航插通讯线 5、完成1-4接线工作（参考图1） 6、设备上电 7、连接串口工具 | 1、通过串口工具下发设置夹爪开口度为400-600指令：EB 90 01 05 12 58 02 90 01 03 2、下发开合夹爪指令查看夹爪开口度（指令参考上方用例） 3、下发保存指令（参考上方用例） 4、断电重启生效 5、检查是否设置成功 | 1、接受应答帧：EE 16 01 02 12 01 16 2、开口限位400-600 5、设置成功
NO.24 | 自研两指夹爪485协议 | Medium | 查询夹爪开口度限位（400-600） | 1、待测试夹爪 2、移动电源（24V供电） 3、485转usb通讯线 4、夹爪航插通讯线 5、完成1-4接线工作（参考图1） 6、设备上电 7、连接串口工具 | 1、通过串口工具下发查询夹爪开口度指令：EB 90 01 01 13 15 2、检查开口度是否正确 | 1、接受应答帧：EE 16 01 05 13 58 02 90 01 04 2、查询的值对应夹爪实际开口度
NO.25 | 自研两指夹爪485协议 | Medium | 急停 | 1、待测试夹爪 2、移动电源（24V供电） 3、485转usb通讯线 4、夹爪航插通讯线 5、完成1-4接线工作（参考图1） 6、设备上电 7、连接串口工具 | 1、下发夹爪开合指令（参考上方用例） 2、通过串口工具下发查询夹爪开口度指令：EB 90 01 01 16 18 3、观察夹爪运动状态 | 2、接受应答帧：EE 16 01 02 16 01 1A 3、夹爪停止开合
NO.26 | 自研两指夹爪485协议 | Medium | 清楚错误 | 1、待测试夹爪 2、移动电源（24V供电） 3、485转usb通讯线 4、夹爪航插通讯线 5、完成1-4接线工作（参考图1） 6、设备上电 7、连接串口工具 | 1、通过串口工具下发清除错误指令：EB 90 01 01 17 19 | 1、接受应答帧：EE 16 01 02 17 01 1B
NO.27 | 自研两指夹爪485协议 | Medium | 以设置的速度300和力控200持续夹取 | 1、待测试夹爪 2、移动电源（24V供电） 3、485转usb通讯线 4、夹爪航插通讯线 5、完成1-4接线工作（参考图1） 6、设备上电 7、连接串口工具 | 1、通过串口工具下发以力矩为200，速度为300持续夹取指令：EB 90 01 05 18 2C 01 C8 00 13 | 1、接受应答帧：EE 16 01 02 18 01 1C
NO.28 | 自研两指夹爪485协议 | Medium | 以设置的速度1和力控50持续夹取 | 1、待测试夹爪 2、移动电源（24V供电） 3、485转usb通讯线 4、夹爪航插通讯线 5、完成1-4接线工作（参考图1） 6、设备上电 7、连接串口工具 | 1、通过串口工具下发以力矩为50，速度为1持续夹取指令：EB 90 01 05 18 01 00 32 00 51 | 1、接受应答帧：EE 16 01 02 18 01 1C
NO.29 | 自研两指夹爪485协议 | Medium | 以设置的速度500和力控500持续夹取 | 1、待测试夹爪 2、移动电源（24V供电） 3、485转usb通讯线 4、夹爪航插通讯线 5、完成1-4接线工作（参考图1） 6、设备上电 7、连接串口工具 | 1、通过串口工具下发以力矩为500，速度为500持续夹取指令：EB 90 01 05 18 F4 01 F4 01 08 | 1、接受应答帧：EE 16 01 02 18 01 1C
NO.30 | 自研两指夹爪485协议 | Medium | 以设置的速度1000和力控1000持续夹取 | 1、待测试夹爪 2、移动电源（24V供电） 3、485转usb通讯线 4、夹爪航插通讯线 5、完成1-4接线工作（参考图1） 6、设备上电 7、连接串口工具 | 1、通过串口工具下发以力矩为1000，速度为1000持续夹取指令：EB 90 01 05 18 E8 03 E8 03 F4 | 1、接受应答帧：EE 16 01 02 18 01 1C
NO.31 | 自研两指夹爪485协议 | Medium | 设置控制力为50 | 1、待测试夹爪 2、移动电源（24V供电） 3、485转usb通讯线 4、夹爪航插通讯线 5、完成1-4接线工作（参考图1） 6、设备上电 7、连接串口工具 | 1、通过串口工具下发设置控制力为50指令：EB 90 01 03 19 32 00 4F 2、下发保存指令（参考上方用例） 3、断电重启生效 4、检查控制力是否设置成功 | 1、接受应答帧：EE 16 01 02 19 01 1D 4、设置成功
NO.32 | 自研两指夹爪485协议 | Medium | 设置控制力为500 | 1、待测试夹爪 2、移动电源（24V供电） 3、485转usb通讯线 4、夹爪航插通讯线 5、完成1-4接线工作（参考图1） 6、设备上电 7、连接串口工具 | 1、通过串口工具下发设置控制力为50指令：EB 90 01 03 19 F4 01 12 2、下发保存指令（参考上方用例） 3、断电重启生效 4、检查控制力是否设置成功 | 1、接受应答帧：EE 16 01 02 19 01 1D 4、设置成功
NO.33 | 自研两指夹爪485协议 | Medium | 设置控制力为1000 | 1、待测试夹爪 2、移动电源（24V供电） 3、485转usb通讯线 4、夹爪航插通讯线 5、完成1-4接线工作（参考图1） 6、设备上电 7、连接串口工具 | 1、通过串口工具下发设置控制力为50指令：EB 90 01 03 19 E8 03 08 2、下发保存指令（参考上方用例） 3、断电重启生效 4、检查控制力是否设置成功 | 1、接受应答帧：EE 16 01 02 19 01 1D 4、设置成功
NO.34 | 自研两指夹爪485协议 | Medium | 设置IO1模式（输入） | 1、待测试夹爪 2、移动电源（24V供电） 3、485转usb通讯线 4、夹爪航插通讯线 5、完成1-4接线工作（参考图1） 6、设备上电 7、连接串口工具 | 1、通过串口工具下发设置IO1输入模式指令：EB 90 01 03 1B 00 00 1F 2、下发查询指令验证是否设置成功（指令参考读取IO输出电平用例） | 1、接受应答帧：EE 16 01 02 1B 01 1F 2、设置成功
NO.35 | 自研两指夹爪485协议 | Medium | 设置IO1模式（输出） | 1、待测试夹爪 2、移动电源（24V供电） 3、485转usb通讯线 4、夹爪航插通讯线 5、完成1-4接线工作（参考图1） 6、设备上电 7、连接串口工具 | 1、通过串口工具下发设置IO1输出模式指令：EB 90 01 03 1B 00 01 20 2、下发查询指令验证是否设置成功（指令参考读取IO输出电平用例） | 1、接受应答帧：EE 16 01 02 1B 01 1F 2、设置成功
NO.36 | 自研两指夹爪485协议 | Medium | 设置IO2模式（输入） | 1、待测试夹爪 2、移动电源（24V供电） 3、485转usb通讯线 4、夹爪航插通讯线 5、完成1-4接线工作（参考图1） 6、设备上电 7、连接串口工具 | 1、通过串口工具下发设置IO2输入模式指令：EB 90 01 03 1B 01 00 20 2、下发查询指令验证是否设置成功（指令参考读取IO输出电平用例） | 1、接受应答帧：EE 16 01 02 1B 01 1F 2、设置成功
NO.37 | 自研两指夹爪485协议 | Medium | 设置IO2模式（输出） | 1、待测试夹爪 2、移动电源（24V供电） 3、485转usb通讯线 4、夹爪航插通讯线 5、完成1-4接线工作（参考图1） 6、设备上电 7、连接串口工具 | 1、通过串口工具下发设置IO2输出模式指令：EB 90 01 03 1B 01 01 21 2、下发查询指令验证是否设置成功（指令参考读取IO输出电平用例） | 1、接受应答帧：EE 16 01 02 1B 01 1F 2、设置成功
NO.38 | 自研两指夹爪485协议 | Medium | 设置IO1输出电平（低电平） | 1、待测试夹爪 2、移动电源（24V供电） 3、485转usb通讯线 4、夹爪航插通讯线 5、完成1-4接线工作（参考图1） 6、设备上电 7、连接串口工具 | 1、通过串口工具下发设置IO1输出低电平指令：EB 90 01 03 1C 00 00 20 2、下发查询指令验证是否设置成功（指令参考读取IO输出电平用例） | 1、接受应答帧：EE 16 01 02 1C 01 20 2、设置成功
NO.39 | 自研两指夹爪485协议 | Medium | 设置IO1输出电平（高电平） | 1、待测试夹爪 2、移动电源（24V供电） 3、485转usb通讯线 4、夹爪航插通讯线 5、完成1-4接线工作（参考图1） 6、设备上电 7、连接串口工具 | 1、通过串口工具下发设置IO1输出高电平指令：EB 90 01 03 1C 00 01 21 2、下发查询指令验证是否设置成功（指令参考读取IO输出电平用例） | 1、接受应答帧：EE 16 01 02 1C 01 20 2、设置成功
NO.40 | 自研两指夹爪485协议 | Medium | 设置IO2输出电平（低电平） | 1、待测试夹爪 2、移动电源（24V供电） 3、485转usb通讯线 4、夹爪航插通讯线 5、完成1-4接线工作（参考图1） 6、设备上电 7、连接串口工具 | 1、通过串口工具下发设置IO2输出低电平指令：EB 90 01 03 1C 01 00 21 2、下发查询指令验证是否设置成功（指令参考读取IO输出电平用例） | 1、接受应答帧：EE 16 01 02 1C 01 20 2、设置成功
NO.41 | 自研两指夹爪485协议 | Medium | 设置IO2输出电平（高电平） | 1、待测试夹爪 2、移动电源（24V供电） 3、485转usb通讯线 4、夹爪航插通讯线 5、完成1-4接线工作（参考图1） 6、设备上电 7、连接串口工具 | 1、通过串口工具下发设置IO2输出高电平指令：EB 90 01 03 1C 01 01 22 2、下发查询指令验证是否设置成功（指令参考读取IO输出电平用例） | 1、接受应答帧：EE 16 01 02 1C 01 20 2、设置成功
NO.42 | 自研两指夹爪485协议 | Medium | 读取IO输出电平（IO1输出高电平，IO2输出低电平） | 1、待测试夹爪 2、移动电源（24V供电） 3、485转usb通讯线 4、夹爪航插通讯线 5、完成1-4接线工作（参考图1） 6、设备上电 7、连接串口工具 | 1、通过串口工具下发读取IO输出电平指令：EB 90 01 01 1D 1F | 1、接受应答帧：EE 16 01 05 1D 01 01 01 00 26
NO.43 | 自研两指夹爪485协议 | Medium | 读取夹爪状态（可参考睿尔曼两指平行夹爪用户手册） | 1、待测试夹爪 2、移动电源（24V供电） 3、485转usb通讯线 4、夹爪航插通讯线 5、完成1-4接线工作（参考图1） 6、设备上电 7、连接串口工具 | 1、通过串口工具下发读取夹爪状态指令：EB 90 01 01 41 43 2、检查指令是否与夹爪实际状态对应 | 1、接受应答帧：EE 16 01 08 41 03 00 2C 01 00 0A 00 84 2、通过
NO.44 | 自研两指夹爪485协议 | Medium | 读取夹爪系统参数（可参考睿尔曼两指平行夹爪用户手册） | 1、待测试夹爪 2、移动电源（24V供电） 3、485转usb通讯线 4、夹爪航插通讯线 5、完成1-4接线工作（参考图1） 6、设备上电 7、连接串口工具 | 1、通过串口工具下发读取夹爪状态指令：EB 90 01 01 42 44 2、检查指令是否与夹爪实际状态对应 | 1、接受应答帧：EE 16 01 0F 42 01 04 00 00 E8 03 2C 01 E8 03 67 00 41 6C 6E 2、通过
NO.45 | 自研两指夹爪485协议 | Medium | 查询夹爪电机状态 | 1、待测试夹爪 2、移动电源（24V供电） 3、485转usb通讯线 4、夹爪航插通讯线 5、完成1-4接线工作（参考图1） 6、设备上电 7、连接串口工具 | 1、通过串口工具下发读取夹爪状态指令：EB 90 01 01 43 45 2、检查指令是否与夹爪实际状态对应 | 1、接受应答帧：EE 16 01 1F 43 01 02 00 00 52 30 25 44 00 00 B8 41 4B 59 06 3C 00 00 00 00 00 00 86 42 00 00 25 44 00 00 61 2、通过
NO.46 | 自研两指夹爪485协议 | Medium | 设置开口度（0） | 1、待测试夹爪 2、移动电源（24V供电） 3、485转usb通讯线 4、夹爪航插通讯线 5、完成1-4接线工作（参考图1） 6、设备上电 7、连接串口工具 | 1、通过串口工具下发设置夹爪开口度为0指令：EB 90 01 03 54 00 00 58 2、检查指令是否与夹爪实际状态对应 | 1、接受应答帧：EE 16 01 02 54 01 58 2、通过
NO.47 | 自研两指夹爪485协议 | Medium | 设置开口度（500） | 1、待测试夹爪 2、移动电源（24V供电） 3、485转usb通讯线 4、夹爪航插通讯线 5、完成1-4接线工作（参考图1） 6、设备上电 7、连接串口工具 | 1、通过串口工具下发设置夹爪开口度为0指令：EB 90 01 03 54 F4 01 4D 2、检查指令是否与夹爪实际状态对应 | 1、接受应答帧：EE 16 01 02 54 01 58 2、通过
NO.48 | 自研两指夹爪485协议 | Medium | 设置开口度（1000） | 1、待测试夹爪 2、移动电源（24V供电） 3、485转usb通讯线 4、夹爪航插通讯线 5、完成1-4接线工作（参考图1） 6、设备上电 7、连接串口工具 | 1、通过串口工具下发设置夹爪开口度为0指令：EB 90 01 03 54 E8 03 43 2、检查指令是否与夹爪实际状态对应 | 1、接受应答帧：EE 16 01 02 54 01 58 2、通过
NO.49 | 自研两指夹爪485协议 | Medium | 查询当前开口度（999时） | 1、待测试夹爪 2、移动电源（24V供电） 3、485转usb通讯线 4、夹爪航插通讯线 5、完成1-4接线工作（参考图1） 6、设备上电 7、连接串口工具 | 1、通过串口工具下发查询夹爪开口指令：EB 90 01 01 D9 DB 2、检查指令是否与夹爪实际状态对应 | 1、接受应答帧：EE 16 01 03 D9 E7 03 C7 2、通过
NO.50 | 自研两指夹爪485协议 | Medium | 设置IO控制使能（打开） | 1、待测试夹爪 2、移动电源（24V供电） 3、485转usb通讯线 4、夹爪航插通讯线 5、完成1-4接线工作（参考图1） 6、设备上电 7、连接串口工具 | 1、通过串口工具下发查询夹爪开口指令：EB 90 01 02 DA 01 DE 2、检查指令是否与夹爪实际状态对应 | 1、接受应答帧：EE 16 01 02 54 01 58 2、通过
NO.51 | 自研两指夹爪485协议 | Medium | 设置IO控制使能（关闭） | 1、待测试夹爪 2、移动电源（24V供电） 3、485转usb通讯线 4、夹爪航插通讯线 5、完成1-4接线工作（参考图1） 6、设备上电 7、连接串口工具 | 1、通过串口工具下发查询夹爪开口指令：EB 90 01 02 DA 00 DD 2、检查指令是否与夹爪实际状态对应 | 1、接受应答帧：EE 16 01 02 54 01 58 2、通过
NO.52 | 自研两指夹爪485协议 | Medium | 设置零位（开口度为0时） | 1、待测试夹爪 2、移动电源（24V供电） 3、485转usb通讯线 4、夹爪航插通讯线 5、完成1-4接线工作（参考图1） 6、设备上电 7、连接串口工具 | 1、通过串口工具下发设置零位指令：EB 90 01 01 DB DD 2、下发夹爪开合指令，观察夹爪实际零位是否修改 | 1、接受应答帧：EE 16 01 02 DB 01 DF 2、通过
NO.53 | 自研两指夹爪485协议 | Medium | 设置零位（开口度为500时） | 1、待测试夹爪 2、移动电源（24V供电） 3、485转usb通讯线 4、夹爪航插通讯线 5、完成1-4接线工作（参考图1） 6、设备上电 7、连接串口工具 | 1、通过串口工具下发设置零位指令：EB 90 01 01 DB DD 2、下发夹爪开合指令，观察夹爪实际零位是否修改 | 1、接受应答帧：EE 16 01 02 DB 01 DF 2、通过
NO.54 | 自研两指夹爪485协议 | Medium | 设置零位（开口度为1000时） | 1、待测试夹爪 2、移动电源（24V供电） 3、485转usb通讯线 4、夹爪航插通讯线 5、完成1-4接线工作（参考图1） 6、设备上电 7、连接串口工具 | 1、通过串口工具下发设置零位指令：EB 90 01 01 DB DD 2、下发夹爪开合指令，观察夹爪实际零位是否修改 | 1、接受应答帧：EE 16 01 02 DB 01 DF 2、通过
NO.55 | 自研两指夹爪485协议 | Medium | 以设置的速度256、力控50、开口度0夹取 | 1、待测试夹爪 2、移动电源（24V供电） 3、485转usb通讯线 4、夹爪航插通讯线 5、完成1-4接线工作（参考图1） 6、设备上电 7、连接串口工具 | 1、通过串口工具下发设置零位指令：EB 90 01 07 E5 01 00 32 00 00 00 20 2、观察夹爪运动状态是否符合指令 | 1、接受应答帧：无 2、通过
NO.56 | 自研两指夹爪485协议 | Medium | 以设置的速度500、力控500、开口度500夹取 | 1、待测试夹爪 2、移动电源（24V供电） 3、485转usb通讯线 4、夹爪航插通讯线 5、完成1-4接线工作（参考图1） 6、设备上电 7、连接串口工具 | 1、通过串口工具下发设置零位指令：EB 90 01 07 E5 F4 01 F4 01 F4 01 CC 2、观察夹爪运动状态是否符合指令 | 1、接受应答帧：无 2、通过
NO.57 | 自研两指夹爪485协议 | Medium | 以设置的速度1000、力控1000、开口度1000夹取 | 1、待测试夹爪 2、移动电源（24V供电） 3、485转usb通讯线 4、夹爪航插通讯线 5、完成1-4接线工作（参考图1） 6、设备上电 7、连接串口工具 | 1、通过串口工具下发设置零位指令：EB 90 01 07 E5 E8 03 E8 03 E8 03 AE 2、观察夹爪运动状态是否符合指令 | 1、接受应答帧：无 2、通过
NO.58 | Modbus RTU通讯协议 | Medium | 读取IO1输出模式 | 1、待测试夹爪 2、移动电源（24V供电） 3、485转usb通讯线 4、夹爪航插通讯线 5、完成1-4接线工作（参考图1） 6、设备上电 7、连接Modbus测试软件（夹爪上位机软件） | 1、通过Modbus工具下发读取IO1输出模式指令：01 01 00 01 00 01 AC 0A 2、验证应答帧准确性 | 1、接受应答帧：01 01 01 00 51 88 2、通过
NO.59 | Modbus RTU通讯协议 | Medium | 读取IO1输出状态 | 1、待测试夹爪 2、移动电源（24V供电） 3、485转usb通讯线 4、夹爪航插通讯线 5、完成1-4接线工作（参考图1） 6、设备上电 7、连接Modbus测试软件（夹爪上位机软件） | 1、通过Modbus工具下发读取IO1输出模式指令：01 01 00 02 00 01 5C 0A 2、验证应答帧准确性 | 1、接受应答帧：01 01 01 01 90 48 2、通过
NO.60 | Modbus RTU通讯协议 | Medium | 读取IO2输出模式 | 1、待测试夹爪 2、移动电源（24V供电） 3、485转usb通讯线 4、夹爪航插通讯线 5、完成1-4接线工作（参考图1） 6、设备上电 7、连接Modbus测试软件（夹爪上位机软件） | 1、通过Modbus工具下发读取IO1输出模式指令：01 01 00 03 00 01 0D CA 2、验证应答帧准确性 | 1、接受应答帧：01 01 01 01 90 48 2、通过
NO.61 | Modbus RTU通讯协议 | Medium | 读取IO2输出状态 | 1、待测试夹爪 2、移动电源（24V供电） 3、485转usb通讯线 4、夹爪航插通讯线 5、完成1-4接线工作（参考图1） 6、设备上电 7、连接Modbus测试软件（夹爪上位机软件） | 1、通过Modbus工具下发读取IO1输出模式指令：01 01 00 04 00 01 BC 0B 2、验证应答帧准确性 | 1、接受应答帧：01 01 01 01 90 48 2、通过
NO.62 | Modbus RTU通讯协议 | Medium | 写入IO1输出模式（输入） | 1、待测试夹爪 2、移动电源（24V供电） 3、485转usb通讯线 4、夹爪航插通讯线 5、完成1-4接线工作（参考图1） 6、设备上电 7、连接Modbus测试软件（夹爪上位机软件） | 1、通过Modbus工具下发写入IO1输出模式指令：01 05 00 01 00 00 9C 0A 2、验证应答帧准确性 | 1、接受应答帧：01 05 00 01 00 00 9C 0A 2、通过
NO.63 | Modbus RTU通讯协议 | Medium | 写入IO1输出模式（输出） | 1、待测试夹爪 2、移动电源（24V供电） 3、485转usb通讯线 4、夹爪航插通讯线 5、完成1-4接线工作（参考图1） 6、设备上电 7、连接Modbus测试软件（夹爪上位机软件） | 1、通过Modbus工具下发写入IO1输出模式指令：01 05 00 01 FF 00 DD FA 2、验证应答帧准确性 | 1、接受应答帧：01 05 00 01 FF 00 DD FA 2、通过
NO.64 | Modbus RTU通讯协议 | Medium | 写入IO1输出状态（高电平） | 1、待测试夹爪 2、移动电源（24V供电） 3、485转usb通讯线 4、夹爪航插通讯线 5、完成1-4接线工作（参考图1） 6、设备上电 7、连接Modbus测试软件（夹爪上位机软件） | 1、通过Modbus工具下发写入IO1输出模式指令：01 05 00 03 FF 00 7C 3A 2、验证应答帧准确性 | 1、接受应答帧：01 05 00 03 FF 00 7C 3A 2、通过
NO.65 | Modbus RTU通讯协议 | Medium | 写入IO1输出状态（低电平） | 1、待测试夹爪 2、移动电源（24V供电） 3、485转usb通讯线 4、夹爪航插通讯线 5、完成1-4接线工作（参考图1） 6、设备上电 7、连接Modbus测试软件（夹爪上位机软件） | 1、通过Modbus工具下发写入IO1输出模式指令：01 05 00 03 00 00 3D CA 2、验证应答帧准确性 | 1、接受应答帧：01 05 00 03 00 00 3D CA 2、通过
NO.66 | Modbus RTU通讯协议 | Medium | 写入IO2输出模式（输入） | 1、待测试夹爪 2、移动电源（24V供电） 3、485转usb通讯线 4、夹爪航插通讯线 5、完成1-4接线工作（参考图1） 6、设备上电 7、连接Modbus测试软件（夹爪上位机软件） | 1、通过Modbus工具下发写入IO2输出模式指令：01 05 00 02 00 00 6C 0A 2、验证应答帧准确性 | 1、接受应答帧：01 05 00 02 00 00 6C 0A 2、通过
NO.67 | Modbus RTU通讯协议 | Medium | 写入IO2输出模式（输出） | 1、待测试夹爪 2、移动电源（24V供电） 3、485转usb通讯线 4、夹爪航插通讯线 5、完成1-4接线工作（参考图1） 6、设备上电 7、连接Modbus测试软件（夹爪上位机软件） | 1、通过Modbus工具下发写入IO2输出模式指令：01 05 00 02 FF 00 2D FA 2、验证应答帧准确性 | 1、接受应答帧：01 05 00 02 FF 00 2D FA 2、通过
NO.68 | Modbus RTU通讯协议 | Medium | 写入IO2输出状态（高电平） | 1、待测试夹爪 2、移动电源（24V供电） 3、485转usb通讯线 4、夹爪航插通讯线 5、完成1-4接线工作（参考图1） 6、设备上电 7、连接Modbus测试软件（夹爪上位机软件） | 1、通过Modbus工具下发写入IO2输出模式指令：01 05 00 04 FF 00 CD FB 2、验证应答帧准确性 | 1、接受应答帧：01 05 00 04 FF 00 CD FB 2、通过
NO.69 | Modbus RTU通讯协议 | Medium | 写入IO2输出状态（低电平） | 1、待测试夹爪 2、移动电源（24V供电） 3、485转usb通讯线 4、夹爪航插通讯线 5、完成1-4接线工作（参考图1） 6、设备上电 7、连接Modbus测试软件（夹爪上位机软件） | 1、通过Modbus工具下发写入IO2输出模式指令：01 05 00 04 00 00 8C 0B 2、验证应答帧准确性 | 1、接受应答帧：01 05 00 04 00 00 8C 0B 2、通过
NO.70 | Modbus RTU通讯协议 | Medium | 保存参数 | 1、待测试夹爪 2、移动电源（24V供电） 3、485转usb通讯线 4、夹爪航插通讯线 5、完成1-4接线工作（参考图1） 6、设备上电 7、连接Modbus测试软件（夹爪上位机软件） | 1、通过Modbus工具下发保存参数指令：01 06 00 01 00 01 19 CA 2、验证应答帧准确性 | 1、接受应答帧：01 06 00 01 00 01 19 CA 2、通过
NO.71 | Modbus RTU通讯协议 | Medium | 参数恢复默认 | 1、待测试夹爪 2、移动电源（24V供电） 3、485转usb通讯线 4、夹爪航插通讯线 5、完成1-4接线工作（参考图1） 6、设备上电 7、连接Modbus测试软件（夹爪上位机软件） | 1、通过Modbus工具下发保存参数指令：01 06 00 02 00 01 E9 CA 2、验证应答帧准确性 | 1、接受应答帧：01 06 00 02 00 01 E9 CA 2、通过
NO.72 | Modbus RTU通讯协议 | Medium | 查询夹爪ID（ID为1时） | 1、待测试夹爪 2、移动电源（24V供电） 3、485转usb通讯线 4、夹爪航插通讯线 5、完成1-4接线工作（参考图1） 6、设备上电 7、连接Modbus测试软件（夹爪上位机软件） | 1、通过Modbus工具下发查询夹爪ID指令：01 03 00 03 00 01 74 0A 2、验证应答帧准确性 | 1、接受应答帧：01 03 02 00 01 79 84 2、通过
NO.73 | Modbus RTU通讯协议 | Medium | 设置夹爪ID | 1、待测试夹爪 2、移动电源（24V供电） 3、485转usb通讯线 4、夹爪航插通讯线 5、完成1-4接线工作（参考图1） 6、设备上电 7、连接Modbus测试软件（夹爪上位机软件） | 1、通过Modbus工具下发设置夹爪ID为1指令：01 06 00 03 00 01 B8 0A 2、验证应答帧准确性 | 1、接受应答帧：01 06 00 03 00 01 B8 0A 2、通过
NO.74 | Modbus RTU通讯协议 | Medium | 查询夹爪波特率（115200时） | 1、待测试夹爪 2、移动电源（24V供电） 3、485转usb通讯线 4、夹爪航插通讯线 5、完成1-4接线工作（参考图1） 6、设备上电 7、连接Modbus测试软件（夹爪上位机软件） | 1、通过Modbus工具下发查询夹爪波特率指令：01 03 00 04 00 01 C5 CB 2、验证应答帧准确性 | 1、接受应答帧：01 03 02 00 04 B9 87 2、通过
NO.75 | Modbus RTU通讯协议 | Medium | 设置夹爪波特率 | 1、待测试夹爪 2、移动电源（24V供电） 3、485转usb通讯线 4、夹爪航插通讯线 5、完成1-4接线工作（参考图1） 6、设备上电 7、连接Modbus测试软件（夹爪上位机软件） | 1、通过Modbus工具下发设置夹爪ID波特率为115200指令：01 06 00 04 00 04 C9 C8 2、验证应答帧准确性 | 1、接受应答帧：01 06 00 04 00 04 C9 C8 2、通过
NO.76 | Modbus RTU通讯协议 | Medium | 单次夹取 | 1、待测试夹爪 2、移动电源（24V供电） 3、485转usb通讯线 4、夹爪航插通讯线 5、完成1-4接线工作（参考图1） 6、设备上电 7、连接Modbus测试软件（夹爪上位机软件） | 1、通过Modbus工具下发夹爪单次夹取指令：01 06 00 05 00 00 99 CB 2、验证应答帧准确性 | 1、接受应答帧：01 06 00 05 00 00 99 CB 2、通过
NO.77 | Modbus RTU通讯协议 | Medium | 持续夹取 | 1、待测试夹爪 2、移动电源（24V供电） 3、485转usb通讯线 4、夹爪航插通讯线 5、完成1-4接线工作（参考图1） 6、设备上电 7、连接Modbus测试软件（夹爪上位机软件） | 1、通过Modbus工具下发夹爪持续夹取指令：01 06 00 05 00 01 58 0B 2、验证应答帧准确性 | 1、接受应答帧：01 06 00 05 00 01 58 0B 2、通过
NO.78 | Modbus RTU通讯协议 | Medium | 松开 | 1、待测试夹爪 2、移动电源（24V供电） 3、485转usb通讯线 4、夹爪航插通讯线 5、完成1-4接线工作（参考图1） 6、设备上电 7、连接Modbus测试软件（夹爪上位机软件） | 1、通过Modbus工具下发夹爪松开指令：01 06 00 06 00 01 A8 0B 2、验证应答帧准确性 | 1、接受应答帧：01 06 00 06 00 01 A8 0B 2、通过
NO.79 | Modbus RTU通讯协议 | Medium | 急停 | 1、待测试夹爪 2、移动电源（24V供电） 3、485转usb通讯线 4、夹爪航插通讯线 5、完成1-4接线工作（参考图1） 6、设备上电 7、连接Modbus测试软件（夹爪上位机软件） | 1、通过Modbus工具下发夹爪急停指令：01 06 00 07 00 01 F9 CB 2、验证应答帧准确性 | 1、接受应答帧：01 06 00 07 00 01 F9 CB 2、通过
NO.80 | Modbus RTU通讯协议 | Medium | 清楚错误 | 1、待测试夹爪 2、移动电源（24V供电） 3、485转usb通讯线 4、夹爪航插通讯线 5、完成1-4接线工作（参考图1） 6、设备上电 7、连接Modbus测试软件（夹爪上位机软件） | 1、通过Modbus工具下发夹爪清除错误指令：01 06 00 08 00 01 C9 C8 2、验证应答帧准确性 | 1、接受应答帧：01 06 00 08 00 01 C9 C8 2、通过
NO.81 | Modbus RTU通讯协议 | Medium | 设置夹爪开口度（1000） | 1、待测试夹爪 2、移动电源（24V供电） 3、485转usb通讯线 4、夹爪航插通讯线 5、完成1-4接线工作（参考图1） 6、设备上电 7、连接Modbus测试软件（夹爪上位机软件） | 1、通过Modbus工具下发设置夹爪开口度指令：01 06 00 09 03 E8 59 76 2、验证应答帧准确性 | 1、接受应答帧：01 06 00 09 03 E8 59 76 2、通过
NO.82 | Modbus RTU通讯协议 | Medium | 读取夹爪开口度 | 1、待测试夹爪 2、移动电源（24V供电） 3、485转usb通讯线 4、夹爪航插通讯线 5、完成1-4接线工作（参考图1） 6、设备上电 7、连接Modbus测试软件（夹爪上位机软件） | 1、通过Modbus工具下发读取夹爪开口度指令：01 03 00 09 00 01 54 08 2、验证应答帧准确性 | 1、接受应答帧：01 03 02 03 E8 B8 FA 2、通过
NO.83 | Modbus RTU通讯协议 | Medium | 设置夹取速度（1000） | 1、待测试夹爪 2、移动电源（24V供电） 3、485转usb通讯线 4、夹爪航插通讯线 5、完成1-4接线工作（参考图1） 6、设备上电 7、连接Modbus测试软件（夹爪上位机软件） | 1、通过Modbus工具下发设置夹取速度指令：01 06 00 0A 03 E8 A9 76 2、验证应答帧准确性 | 1、接受应答帧：01 06 00 0A 03 E8 A9 76 2、通过
NO.84 | Modbus RTU通讯协议 | Medium | 读取夹取速度 | 1、待测试夹爪 2、移动电源（24V供电） 3、485转usb通讯线 4、夹爪航插通讯线 5、完成1-4接线工作（参考图1） 6、设备上电 7、连接Modbus测试软件（夹爪上位机软件） | 1、通过Modbus工具下发读取夹取速度指令：01 03 00 0A 00 01 A4 08 2、验证应答帧准确性 | 1、接受应答帧：01 03 02 03 E8 B8 FA 2、通过
NO.85 | Modbus RTU通讯协议 | Medium | 设置夹取力度（1000） | 1、待测试夹爪 2、移动电源（24V供电） 3、485转usb通讯线 4、夹爪航插通讯线 5、完成1-4接线工作（参考图1） 6、设备上电 7、连接Modbus测试软件（夹爪上位机软件） | 1、通过Modbus工具下发设置夹取力度指令：01 06 00 0B 03 E8 F8 B6 2、验证应答帧准确性 | 1、接受应答帧：01 06 00 0B 03 E8 F8 B6 2、通过
NO.86 | Modbus RTU通讯协议 | Medium | 读取夹取力度 | 1、待测试夹爪 2、移动电源（24V供电） 3、485转usb通讯线 4、夹爪航插通讯线 5、完成1-4接线工作（参考图1） 6、设备上电 7、连接Modbus测试软件（夹爪上位机软件） | 1、通过Modbus工具下发读取夹取速度指令：01 03 00 0B 00 01 F5 C8 2、验证应答帧准确性 | 1、接受应答帧：01 03 02 03 E8 B8 FA 2、通过
NO.87 | Modbus RTU通讯协议 | Medium | 设置最大开口度（1000） | 1、待测试夹爪 2、移动电源（24V供电） 3、485转usb通讯线 4、夹爪航插通讯线 5、完成1-4接线工作（参考图1） 6、设备上电 7、连接Modbus测试软件（夹爪上位机软件） | 1、通过Modbus工具下发设置最大开口度指令：01 06 00 0C 03 E8 49 77 2、验证应答帧准确性 | 1、接受应答帧：01 06 00 0C 03 E8 49 77 2、通过
NO.88 | Modbus RTU通讯协议 | Medium | 读取最大开口度 | 1、待测试夹爪 2、移动电源（24V供电） 3、485转usb通讯线 4、夹爪航插通讯线 5、完成1-4接线工作（参考图1） 6、设备上电 7、连接Modbus测试软件（夹爪上位机软件） | 1、通过Modbus工具下发读取最大开口度指令：01 03 00 0C 00 01 44 09 2、验证应答帧准确性 | 1、接受应答帧：01 03 02 03 E8 B8 FA 2、通过
NO.89 | Modbus RTU通讯协议 | Medium | 设置最小开口度 | 1、待测试夹爪 2、移动电源（24V供电） 3、485转usb通讯线 4、夹爪航插通讯线 5、完成1-4接线工作（参考图1） 6、设备上电 7、连接Modbus测试软件（夹爪上位机软件） | 1、通过Modbus工具下发设置最小开口度指令：01 06 00 0D 00 00 18 09 2、验证应答帧准确性 | 1、接受应答帧：01 06 00 0D 00 00 18 09 2、通过
NO.90 | Modbus RTU通讯协议 | Medium | 读取最小开口度 | 1、待测试夹爪 2、移动电源（24V供电） 3、485转usb通讯线 4、夹爪航插通讯线 5、完成1-4接线工作（参考图1） 6、设备上电 7、连接Modbus测试软件（夹爪上位机软件） | 1、通过Modbus工具下发读取最小开口度指令：01 03 00 0D 00 01 15 C9 2、验证应答帧准确性 | 1、接受应答帧：01 03 02 00 00 B8 44 2、通过
NO.91 | Modbus RTU通讯协议 | Medium | 读取实际力度 | 1、待测试夹爪 2、移动电源（24V供电） 3、485转usb通讯线 4、夹爪航插通讯线 5、完成1-4接线工作（参考图1） 6、设备上电 7、连接Modbus测试软件（夹爪上位机软件） | 1、通过Modbus工具下发读取实际力度指令：01 03 00 0E 00 01 E5 C9 2、验证应答帧准确性 | 1、接受应答帧：01 03 02 00 09 78 42 2、通过
NO.92 | Modbus RTU通讯协议 | Medium | 读取实际位置 | 1、待测试夹爪 2、移动电源（24V供电） 3、485转usb通讯线 4、夹爪航插通讯线 5、完成1-4接线工作（参考图1） 6、设备上电 7、连接Modbus测试软件（夹爪上位机软件） | 1、通过Modbus工具下发读取实际力度指令：01 03 00 0F 00 01 B4 09 2、验证应答帧准确性 | 1、接受应答帧：01 03 02 03 E7 F8 FE 2、通过
NO.93 | Modbus RTU通讯协议 | Medium | 读取实际电流 | 1、待测试夹爪 2、移动电源（24V供电） 3、485转usb通讯线 4、夹爪航插通讯线 5、完成1-4接线工作（参考图1） 6、设备上电 7、连接Modbus测试软件（夹爪上位机软件） | 1、通过Modbus工具下发读取实际力度指令：01 03 00 10 00 01 85 CF 2、验证应答帧准确性 | 1、接受应答帧：01 03 02 00 63 F8 6D 2、通过
NO.94 | Modbus RTU通讯协议 | Medium | 读取实际电压 | 1、待测试夹爪 2、移动电源（24V供电） 3、485转usb通讯线 4、夹爪航插通讯线 5、完成1-4接线工作（参考图1） 6、设备上电 7、连接Modbus测试软件（夹爪上位机软件） | 1、通过Modbus工具下发读取实际力度指令：01 03 00 11 00 01 D4 0F 2、验证应答帧准确性 | 1、接受应答帧：01 03 02 00 17 F8 4A 2、通过
NO.95 | Modbus RTU通讯协议 | Medium | 读取实际温度 | 1、待测试夹爪 2、移动电源（24V供电） 3、485转usb通讯线 4、夹爪航插通讯线 5、完成1-4接线工作（参考图1） 6、设备上电 7、连接Modbus测试软件（夹爪上位机软件） | 1、通过Modbus工具下发读取实际力度指令：01 03 00 12 00 01 24 0F 2、验证应答帧准确性 | 1、接受应答帧：01 03 02 00 34 B9 93 2、通过
NO.96 | Modbus RTU通讯协议 | Medium | 读取错误码 | 1、待测试夹爪 2、移动电源（24V供电） 3、485转usb通讯线 4、夹爪航插通讯线 5、完成1-4接线工作（参考图1） 6、设备上电 7、连接Modbus测试软件（夹爪上位机软件） | 1、通过Modbus工具下发读取实际力度指令：01 03 00 13 00 01 75 CF 2、验证应答帧准确性 | 1、接受应答帧：01 03 02 00 00 B8 44 2、通过
NO.97 | Modbus RTU通讯协议 | Medium | 读取夹爪状态码 | 1、待测试夹爪 2、移动电源（24V供电） 3、485转usb通讯线 4、夹爪航插通讯线 5、完成1-4接线工作（参考图1） 6、设备上电 7、连接Modbus测试软件（夹爪上位机软件） | 1、通过Modbus工具下发读取实际力度指令：01 03 00 14 00 01 C4 0E 2、验证应答帧准确性 | 1、接受应答帧：01 03 02 00 03 F8 45 2、通过
