Simo-realman/Two-Finger-Gripper/Hardware/BOT PCBV2.pdf

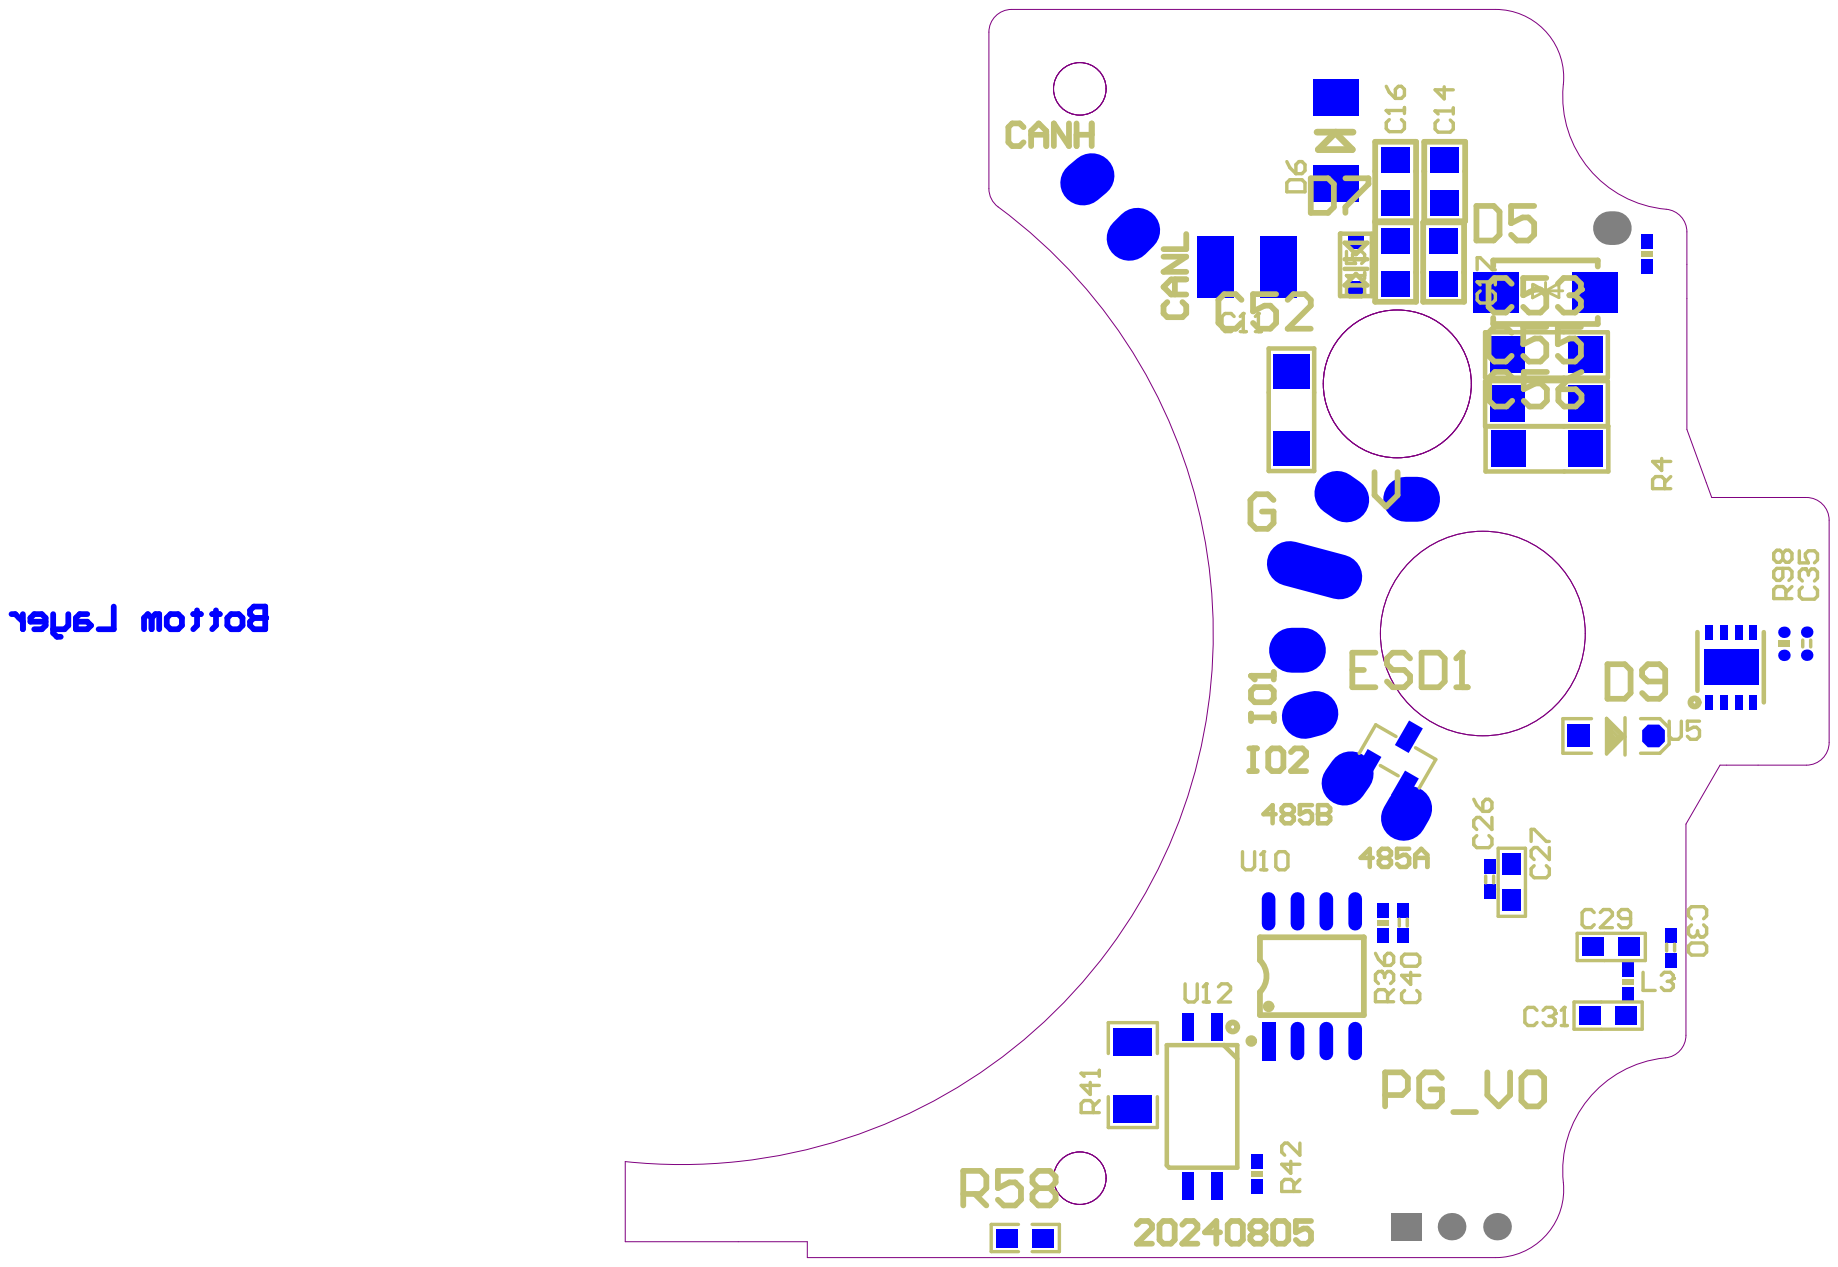
[picture p20: page 1]
