Simo-realman/Two-Finger-Gripper/Hardware/TOP PCBV2.pdf

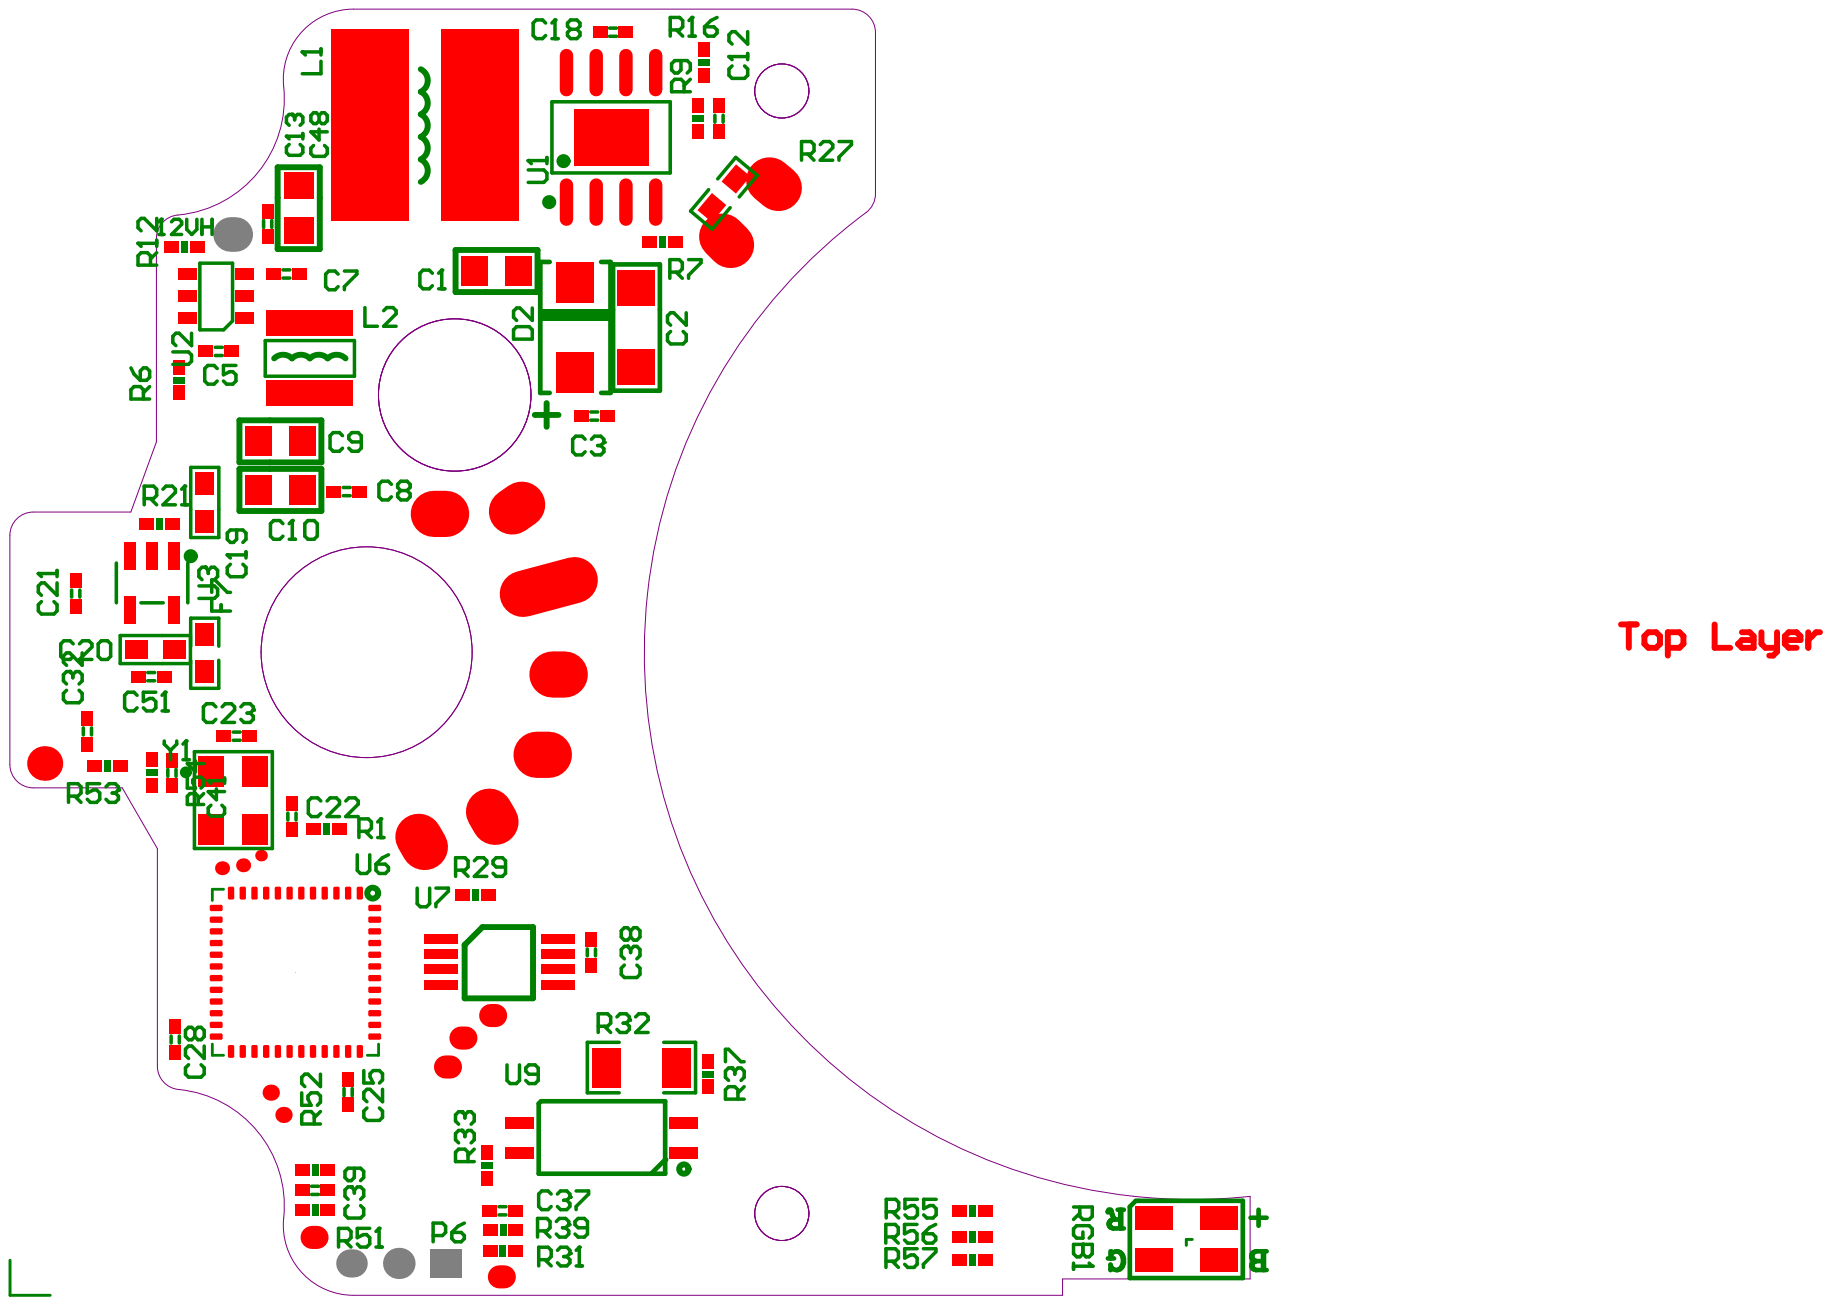
[picture p21: page 1]
