Simo-realman/Two-Finger-Gripper/(list of files, drawings)

Other design files:
Hardware/PCB/TURN PCB.PcbDoc
Hardware/SCH/PG_V0.SchDoc
