Simo-realman/Two-Finger-Gripper/Software/gripper_app/Keil/board.ioc

Mcu.UserName=STM32G431CBUx
PA0.GPIO_Label=LED_B
PA0.Signal=GPIO_Output
PA10.GPIO_Label=POWER_12V
PA10.Signal=GPIO_Output
PA13.Signal=SYS_JTMS-SWDIO
PA14.Signal=SYS_JTCK-SWCLK
PA4.GPIO_Label=SWITCH2
PA4.Signal=GPIO_Input
PA7.Signal=ADC2_IN4
PB10.GPIO_Label=DIN2
PB10.Signal=GPIO_Input
PB13.GPIO_Label=SWITCH1
PB13.Signal=GPIO_Input
PB14.GPIO_Label=LED_G
PB14.Signal=GPIO_Output
PB3.GPIO_Label=POWER_5V
PB3.Signal=GPIO_Output
PB4.GPIO_Label=POWER_24V
PB4.Signal=GPIO_Output
PB6.Signal=USART1_TX
PB7.Signal=USART1_RX
PB8-BOOT0.Signal=FDCAN1_RX
PB9.Signal=FDCAN1_TX
PC10.Signal=USART3_TX
PC11.Signal=USART3_RX
PC14-OSC32_IN.GPIO_Label=DIN1
PC14-OSC32_IN.Signal=GPIO_Input
PC4.Signal=SharedAnalog_PC4
PF0-OSC_IN.Signal=RCC_OSC_IN
PF1-OSC_OUT.Signal=RCC_OSC_OUT
