Simo-realman/Two-Finger-Gripper/Software/gripper_app/Keil/Application/Inc/main.h

#ifndef __MAIN_H
#define __MAIN_H

#ifdef __cplusplus
extern "C" {
#endif

#include "common.h"
#include "stm32g4xx_hal.h"

void Error_Handler(void);

#ifdef __cplusplus
}
#endif

#endif /* __MAIN_H */
