Simo-realman/Two-Finger-Gripper/Software/gripper_app/Code/apl/apl_dbg.h

#ifndef MY_DBG_H__
#define MY_DBG_H__

#ifdef __cplusplus
extern "C" {
#endif

#include "common.h"
	
/* DEBUG level */
#define DBG_ERROR           0
#define DBG_WARNING         1
#define DBG_INFO            2
#define DBG_LOG             3

#ifdef DBG_TAG
#ifndef DBG_SECTION_NAME
#define DBG_SECTION_NAME    DBG_TAG
#endif
#else
/* compatible with old version */
#ifndef DBG_SECTION_NAME
#define DBG_SECTION_NAME    "DBG"
#endif
#endif /* DBG_TAG */

#ifdef DBG_ENABLE /* DBG_ENABLE */

#ifdef DBG_LVL
#ifndef DBG_LEVEL
#define DBG_LEVEL         DBG_LVL
#endif
#else
/* compatible with old version */
#ifndef DBG_LEVEL
#define DBG_LEVEL         DBG_WARNING
#endif
#endif /* DBG_LVL */

#define _DBG_COLOR(n)
#define _DBG_LOG_HDR(lvl_name, color_n)                    \
    log_printf("[" lvl_name "/" DBG_SECTION_NAME "] ")
#define _DBG_LOG_X_END                                     \
    log_printf("\n")

#define dbg_log_line(lvl, color_n, fmt, ...)                \
    do                                                      \
    {                                                       \
        _DBG_LOG_HDR(lvl, color_n);                         \
        log_printf(fmt, ##__VA_ARGS__);                     \
        _DBG_LOG_X_END;                                     \
    }                                                       \
    while (0)

#else /* DBG_ENABLE */
#define dbg_log_line(lvl, color_n, fmt, ...)
#endif /* DBG_ENABLE */


#if (DBG_LEVEL >= DBG_LOG)
#define LOG_D(fmt, ...)      dbg_log_line("D", 0, fmt, ##__VA_ARGS__)
#else
#define LOG_D(...)
#endif

#if (DBG_LEVEL >= DBG_INFO)
#define LOG_I(fmt, ...)      dbg_log_line("I", 32, fmt, ##__VA_ARGS__)
#else
#define LOG_I(...)
#endif

#if (DBG_LEVEL >= DBG_WARNING)
#define LOG_W(fmt, ...)      dbg_log_line("W", 33, fmt, ##__VA_ARGS__)
#else
#define LOG_W(...)
#endif

#if (DBG_LEVEL >= DBG_ERROR)
#define LOG_E(fmt, ...)      dbg_log_line("E", 31, fmt, ##__VA_ARGS__)
#else
#define LOG_E(...)
#endif


#ifdef __cplusplus
}
#endif

#endif /* RT_DBG_H__ */
