Simo-realman/Two-Finger-Gripper/Software/gripper_app/Code/hal/hal_iwdg.h

#ifndef __HAL_IWDG_H__
#define __HAL_IWDG_H__

#ifdef __cplusplus
extern "C" {
#endif

#include "main.h"

void __hal_iwdg_init(void);
void __hal_iwdg_reload(void);

#ifdef __cplusplus
}
#endif
#endif /*__ GPIO_H__ */
