Simo-realman/Two-Finger-Gripper/Software/gripper_tool/tipwidget.h

#ifndef _TTipWidget_H_
#define _TTipWidget_H_

#include <QWidget>
#include <QLabel>
#include <QTimer>

enum {
  TIPINFO = 0x01,
  TIPWARRING,
  TIPERROR,
};

//消息提示
class TTipWidget :public QLabel
{
    Q_OBJECT

public:
    static TTipWidget *Instance();
    static void ExitInstance();
    void SetMesseage(const int type, const QString &strMessage, const QPoint *pPoint=nullptr);

private:
    TTipWidget();
    ~TTipWidget();

    void OnTimer();
    void enterEvent(QEvent *);
    void leaveEvent(QEvent *);

private:
    static TTipWidget *m_pTipWidget;
    QWidget *m_pParent;
    QTimer  *m_pTimer;
    bool     m_bEnter;
    int      m_nTransparent;
};

#define AUTOTIP TTipWidget::Instance()

#endif // _TTipWidget_H_
