Simo-realman/Two-Finger-Gripper/(commit log)

2024-12-25 fix:first commit
    [4810009-2820242.drl, 4810009-2820242.gbl, 4810009-2820242.gbo, 4810009-2820242.gbp, 4810009-2820242.gbs, 4810009-2820242.gko, 4810009-2820242.gtl, 4810009-2820242.gto]
2024-12-25 perf:Optimize the switching between Chinese and English documents
2024-12-25 Update readme.md
    修改说明格式
2024-12-25 Update readme_CN.md
    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
2024-12-27 修复线序
2025-01-13 Update readme.md
    更新连接
2025-01-13 Update readme_CN.md
    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
2025-01-16 更新航插头
    更新航插头
